somebox/rgb-spotlight/DESIGN.md

# RGB Spotlight — design notes

Status (2026-10-31): both boards routed and DRC clean, `pcbkit check` clean or explained (LAYOUT.md). One LED channel simulated (§2.7). Failure review in `docs/reviews/2026-10-30-v2.md`; its accepted changes are planned, not yet applied (§6, "Planned changes"). Next: apply them, settle LED polarity, then the order (PRODUCTION.md).

Chainable, WS2811-addressed RGB spotlight: three 3 W LEDs, each on its own PT4115 constant-current buck, run from a 12 V chain. Two boards in an aluminium cylinder:
- an **aluminium LED board** (50 mm, 1 layer) carrying only the LEDs;
- an **FR4 driver / interface board** (50 mm, 2 layers) 4–6 cm behind it, with the drivers, logic and connectors.

KiCad 10, generated by the project's scripts, with the shared tooling from pcb-kit (`~/src/pcb-kit`, `pcbkit ...`). The PCB itself is in [LAYOUT.md](LAYOUT.md), ordering in [PRODUCTION.md](PRODUCTION.md).

- **Schematics:** driver ERC 0/0 and 63 topology checks pass; LED board ERC shows 3 benign warnings (§4).
- **Boards:** LED board fully generated and routed; driver routed by script (LAYOUT.md). Both on the `disc50` outline preset.

| Path | What |
|---|---|
| `boards/driver/` | Driver / interface board (FR4). Schematic from `scripts/sch_driver.py`; board from `scripts/make_driver_pcb.sh` |
| `boards/led/` | LED board (aluminium). Schematic from `scripts/sch_led.py`; board from `scripts/make_led_pcb.sh` (placement and routing) |
| `lib/` | Project symbols (`PT4115`, `LED_HD2525`, 3-unit `LED_PORT`), footprints (`LED_XINGLIGHT_HD2525`, `WirePad_2.2x3.5mm`) and the 3D model, all written by `scripts/make_lib.py` |
| `scripts/` | The project's generators and checks (schematics, boards, routing, outline presets, netlist assertions). Shared parts come from pcb-kit: `pcbkit.schematic` (via `builder.py`), the silk placer, the blank board, DRC/ERC/checks, previews and fab |
| `sim/` | ngspice simulation of one LED channel (`sim/channel.py`, §2.7); tables and plots in `sim/results/` |
| `archive/v1-easyeda/` | v1 EasyEDA exports, the KiCad import of the v1 board, its as-built netlist, the v1 BOM doc and the bodge image |
| `docs/previews/<board>/` | Schematic PDF, front/back PNGs, 3D renders, printable PDF (`scripts/make_previews.sh` -> `pcbkit previews`); driver `placement-ratsnest.png` (`scripts/ratsnest.py`); `outline-presets.png` |
| `docs/BOM_driver.md`, `docs/BOM_led.md` | bomi BOMs. Each board folder has its own `.bomi/project.yaml` |
| `docs/datasheets/` | PDFs (git-ignored) plus bomi summaries |

```sh
python3 scripts/make_lib.py                         # project symbols + footprints
python3 scripts/sch_driver.py && python3 scripts/sch_led.py   # rebuild both schematics (Konnect); overwrites them
pcbkit erc boards/driver/driver.kicad_sch           # ERC summary (same for boards/led)
python3 scripts/netcheck.py                         # driver topology assertions (exit 1 on failure)
scripts/make_led_pcb.sh                             # LED board: placement, routing, islands, DRC (fully generated)
scripts/make_driver_pcb.sh --force --route          # driver board: placement + routing (about 6 min) + DRC; refuses hand-edited boards without --force
pcbkit drc boards/<b>/<b>.kicad_pcb --save && pcbkit check boards/<b>/<b>.kicad_pcb   # board checks (LAYOUT.md)
scripts/make_previews.sh [driver|led|all]           # docs/previews/<board>/
pcbkit release [--dry-run]                          # versioned order files in releases/<board>/v<version>/ (PRODUCTION.md, pcbkit.toml)
scripts/make_fab.sh <driver|led>                    # unversioned order files in build/fab/<board>/, for a look before releasing
python3 sim/channel.py                              # LED channel simulation (§2.7); add --plot under uv for the PNGs
<KiCad python> scripts/set_outline.py <driver|led|all> <disc50|disc55|disc60|tabs3>   # change the board edge in place (LAYOUT.md)
bomi --project boards/driver list --check           # stock check; same for boards/led
```

## Decisions

Numbered and dated; a reversal is a new entry naming the old one.

| # | Date | Decision | Why |
| --- | --- | --- | --- |
| D1 | 2026-10-05 | Restart in KiCad; v1 is not reworked (only a one-channel bodge for testing, §5) | v1 had the PT4115 stage wired as the wrong kind of buck and an unpowered 74HC04 (§1) |
| D2 | 2026-10-05 | PT4115 per its datasheet: 12 V → Rs → LED → L → SW, Schottky SW → 12 V | the datasheet topology for its low-side switch and high-side sense; v1 had it wrong (F1) |
| D3 | 2026-10-05 | One `+5V` net; netlist assertions for every v1 failure (`scripts/netcheck.py`) | F2; ERC can't tell intent |
| D4 | 2026-10-05 | J1 and J2 share one pinout (1 = 12V, 2 = DATA, 3 = GND) | v1's mirrored J2 needed reversed cables |
| D5 | 2026-10-05 | 68 µH inductor, 10 µF 50 V 1206 input caps, 0.22 Ω 1206 300 ppm sense resistors | PT4115 inductor table for 0.4–0.8 A; ≥ 4.7 µF after DC bias; tempco |
| D6 | 2026-10-05 | DIN: 100 Ω series + 10 k pull-down; DOUT: 33 Ω; WS2811 SET on a DNP 0 Ω strap | hot-plugged cables, defined idle, F3 open question |
| D7 | 2026-10-05 | Two boards: aluminium LED board + FR4 driver board 4–6 cm behind it | 2.7 W of LED heat needs an aluminium path to the housing (§2.6) |
| D8 | 2026-10-05 | LEDs spread on a 12 mm ring, each on its own copper island | separated colours are the intended effect; slug isolation unspecified |
| D9 | 2026-10-05 | JST XH 3-pin (3 A) in/out on the driver's back; JST PH 6 harness to the LEDs | chaining current; plastic connectors off the light side |
| D10 | 2026-10-05 | SMAJ15A TVS + 22 µF on the 12 V input | hot-plugged chain cables ring to ~2 × 12 V |
| D11 | 2026-10-06 | Parts and copper inside a 50 mm core; board edge from an outline preset | the housing (size, mounting) is not decided yet |
| D12 | 2026-10-11 | 12 V trunk as an arc from J1 over the top to the blue cell (no closed ring); PWR net class 0.8 mm, the 1.5 mm pass-through drawn explicitly | `pcbkit check`: no loops, class width = tap width |
| D13 | 2026-10-11 | Chain at most 6 lights per 12 V feed (2.5 A); 7 is at the XH connector's 3 A. Replaced by D14 | simulated 0.42 A per light at full white (§2.7) |
| D14 | 2026-10-31 | One 12 V feed runs at most 5 lights, up to 3 m apart on 22 AWG: 36 W supply for 4 lights plus controller, 60 W for 5 (§2.4). Replaces D13 | at the tolerance corners 5 lights draw 2.43–2.62 A, 6 about 2.9 A or more, on a 3 A connector with no derating for a warm housing. The board can't run from 5 V (review, "Power and data") |
| D15 | 2026-10-31 | 3 A fuse per feed at the supply end. Longer chains get another feed per group of 5, pin 1 open between groups | the supply can outrun the XH rating, and it limits a reversed cable (review R5, R7). No board change |
| D16 | 2026-10-31 | No extra repeater on the board | each light already has pcb-kit's repeater part on its input (U7) and the WS2811 reshapes on its output. Simulated clean over 8 m (review, "Power and data"), and the datasheet allows 4 m |
| D17 | 2026-10-31 | Planned: U6 74HC04 → 74HC14D (C5605, Basic) | WS2811 edges can be 120 µs; the 74HC04 needs under 139 ns/V or may oscillate (review R4). Same pinout |
| D18 | 2026-10-31 | Planned: C1 100 nF → 1 µF (C52923); R10 100 Ω → 1 kΩ (C11702). Replaces D6's 100 Ω | datasheet's Ci for VDD (R3); limits the clamp current from 12 V on the data pin and from cable ringing (R6) |
| D19 | 2026-10-31 | Planned: "+" on the LED board's silk at pad 2 of each LED, polarity in the order remark | the part's dot marks the anode, our silk and LCSC's dot mark pad 1, the cathode (R1) |
| D20 | 2026-10-31 | Nylon washers or screws on the driver; a sleeve or grommet through the LED board's wire hole | the housing floats and can isolate the board, so no keep-out re-route is needed (R8, R9) |

---

## 1. v1 post-mortem (EasyEDA, ordered Mar 2026)

Sources: the EasyEDA schematic and PCB exports (2026-10-05), the as-built netlist taken from the PCB pads (`archive/v1-easyeda/v1-netlist.txt`), a copper connectivity trace of the KiCad import (`v1-easyeda.kicad_pcb`), and the bench measurements in the Cursor review transcript.

**Measured on the board (transcript):** 12 V and 5 V present on the IC pins; 400 kHz data present on DIN and on DIN_5V (5–6 V p-p); WS2811 VDD = 5 V; WS2811 OUTR/G/B silent (DIM_x_RAW sits at 5 V); a 2 kΩ pull-up on DIM_G did nothing; the same ESP32 output drives a WS2812 panel fine.

### F1 — PT4115 power stage wired as the wrong kind of buck (all three channels) — would never light

v1 wired each channel like a conventional buck with a *high-side* switch:

```
v1:   12V ─ Rs ─ CSN            (Rs carries no LED current: only the 8 µA CSN pin current)
      SW ─┬─ L ─ LED(A→K) ─ GND
          └─ D (K on SW, A on GND)
```

The PT4115 is a **low-side** switch (SW is the drain of an internal NMOS to GND) with **high-side** current sense. The datasheet (§8, application figure 1) puts the LED and inductor between the sense resistor and SW:

```
v2:   12V ─ Rs ─┬─ CSN
                └─ LED(A→K) ─ L ─ SW      D: A on SW, K on 12V (VIN)
```

With the v1 wiring no LED current can flow:

- with the switch on, SW is at 0 V and so is everything on the LED's side;
- with it off, nothing sources current.

Rs sees 0 mV, so the comparator holds the switch on permanently. Forcing DIM high would not have lit anything either. The v1 BOM doc's connection tables (`archive/v1-easyeda/rgb-spotlight-bom-v1.md`) and the Cursor review ("PT4115 buck topology is correct … Schottky anode to GND, cathode to SW … LED cathode to GND") both describe this same wrong topology.

### F2 — 74HC04 VCC on its own net

The schematic used two power names, `+5V` and `5V`. U6 pin 14 and C2 sat on `+5V`, which connects only to C2 (copper trace confirms: U6.14 → C2.2 only). The inverter was unpowered or back-fed through its input clamps, so the DIM pins were undefined. This is probably one of the "miswirings" fixed by hand. v2 has one `+5V` net, and `netcheck.py` asserts every logic VCC is on it.

### F3 — WS2811 receives data but its outputs never change (open)

2026-10-31: the owner recalls later seeing PWM from the chip on a scope, but v1 had too many faults for that to settle anything, so F3 stays open. Treat the WS2811 as untested until v2 bring-up.

Copper was checked pad by pad on the import:

- J1.2 → U7.2 (A), and U7.4 (Y) → U1.6 (DIN). **U7's A and Y are not swapped.**
- U1.8 → 5 V and U1.4 → GND are both connected, and the U1 footprint pin order matches the datasheet.

So the board connects correctly. The candidates left, with the tests in §5:

1. **Latch (reset) time.** The Worldsemi V2.2 datasheet needs **≥ 280 µs low** before outputs update. Older WS2812 parts latch after 50 µs, and some drivers only leave about 50 µs between frames. If frames arrive back to back, the WS2811 shifts data but never latches. That matches the symptom: outputs stuck off while data is present.
2. **Data rate.** The V2.2 part is specified at 800 kbit/s only (T0H 220–380 ns, T1H 580 ns–1 µs). The 400 kHz "WS2811 mode" (T0H ≈ 500 ns, T1H ≈ 1.2 µs) is outside its spec. Test at 800 kHz, which is FastLED's plain `WS2811` (not `WS2811_400`).
3. **Pin 7.** V2.2 calls it NC, but older WS2811 datasheets and clones use it as SET (400/800 kHz select). v1 left it floating. v2 adds a do-not-fit 0 Ω strap (R9) to +5V.
4. **Placement or damage.** U1 may have been placed rotated (check the pin-1 dot against the silkscreen) or damaged during the earlier miswiring.

### Checked and correct in v1

- 78L05G-AB3-R pinout on the PCB: 1 OUT, 2 GND, 3 IN, per the UTC ordering table "O G I". The *v1 BOM doc table* listing pins as GND/VIN/VOUT was wrong, but the schematic and PCB were right.
- WS2811, 74HC04 and 74AHCT1G125 pin maps.
- LED pads (EasyEDA symbol: pad 1 = K, pad 2 = A). Physical orientation is still to be verified (§6).

### Convention, not a fault: connector pin order

v1 used J1 = 12V/DIN/GND and J2 = GND/DOUT/12V, so the chain depends on a reversed (pin 1 ↔ pin 3) cable. A pin-1-to-pin-1 cable would put 12 V on the next board's GND. v2 gives both connectors the same order (1 = 12V, 2 = data, 3 = GND) for pin-1-to-pin-1 cables. **Check which kind of JST PH cable you have.** If yours are reversed, swap J2's pins 1 and 3 in `sch_main.py`.

---

## 2. v2 circuit

### 2.1 LED channels (×3, PT4115)
- Topology per datasheet: 12 V → Rs → (CSN, LED anode); LED cathode → L → SW; Schottky anode on SW, cathode on 12 V; 10 µF across VIN–GND at the pin.
- **I_LED = 0.1 V / Rs = 0.1 / 0.22 = 455 mA.** Datasheet limits: Rs ≥ 0.082 Ω, LED max 1 A / 3 W. Rs dissipation is 45 mW (1206, 250 mW).
- **Inductor 68 µH** (FNR6045S680MT, Isat 1.1 A, DCR 0.38 Ω). The datasheet table gives 47–68 µH for 0.4–0.8 A, and Isat ≥ 1.3–1.5 × I_out. v1 used 100 µH, the value for I ≤ 0.4 A.
- **Switching frequency** (hysteresis ±15 % → ΔI ≈ 136 mA; R_SW 0.6 Ω at 12 V):
  - red, VF ≈ 2.2 V: t_on ≈ 1.0 µs, t_off ≈ 3.2 µs, so ≈ 240 kHz;
  - green/blue, VF ≈ 3.2 V: t_on ≈ 1.15 µs, t_off ≈ 2.3 µs, so ≈ 290 kHz.

  Both are under the 1 MHz limit.
- **Input cap** 10 µF 50 V X5R 1206. The datasheet asks for at least 4.7 µF; v1's 0805 25 V part keeps only about 3–4 µF at 12 V bias.
- **DIM:** 0 V = off, > 2.5 V = full, internal 200 kΩ pull-up to 5 V, abs max 6 V. It is driven by 74HC04 outputs at 5 V.
  - WS2811 PWM runs at about 4 kHz. The PT4115 holds its 0.02 % minimum duty at 100 Hz but needs 4 % at 20 kHz. Expect roughly the bottom 1 % (2–3 of 255 levels) to be dark or non-linear.

### 2.2 Data path
- **J1.2 → R10 100 Ω → (R7 10k to GND) → 74AHCT1G125 → WS2811 DIN.** R10 limits current into the buffer input when a hot-plugged cable rings.
  - AHCT input VIH = 2.0 V, so 3.3 V or 5 V controllers both work; WS2811 VIH is 0.55·VDD = 2.75 V.
  - R7 holds the line low when unplugged, which also keeps the WS2811 in reset.
  - OE is tied straight to GND. v1's R7 pull-down on OE did the same job; that resistor now goes to DIN.
- **WS2811 DO → R8 33 Ω → J2.2:** source termination for the cable. Each WS2811 regenerates the signal at 5 V.
- **R9 (0 Ω, not fitted):** pin 7 (SET) to +5V. Fit it only if bring-up shows the part needs it (§1 F3).

### 2.3 Inversion (unchanged idea, now powered)
WS2811 outputs are 20 V-tolerant constant-current sinks (≈ 16 mA) and sink when a channel is on.
- R4–R6 (4.7 kΩ to 5 V) limit that to 1.06 mA, so the outputs pull fully low.
- The 74HC04 inverts, so DIM is high when the channel is on: 0xFF → full on, 0x00 → off, with standard NeoPixel software.
- Gates 4–6: inputs to GND, outputs open.

### 2.4 Logic supply and 12 V input
78L05 (SOT-89, O-G-I) from 12 V, with 10 µF in and 100 nF out. Load is about 5 mA: WS2811 0.3 mA, 3 × 1.06 mA pull-ups, R7 up to 0.5 mA, gate quiescent. That dissipates ≈ 35 mW. Each logic IC has its own 100 nF.

**12 V input:** an SMAJ15A TVS (breakdown ≥ 16.7 V, clamps 24.4 V) and a 22 µF 1206 at J1. Hot-plugging a cable onto ceramic-only inputs can ring to about 2 × 12 V; the PT4115 is rated to 35 V and the caps to 25/50 V.
- J1 → J2 carry +12V and GND straight through; JST XH is rated 3 A.
**Power for one feed (D14).** A feed is one 12 V supply output, fused, running up to 5 lights at full white. Worst case means the high-current corner with the highest LED VF bins (5.51 W per light); typical is the simulated 5.0 W (§2.7). The worst case stays at 5.51 W as the voltage falls, so the current rises. Numbers are in `sim/results/worst_case.txt`, with 22 AWG and XH contacts assumed at 20 mΩ each.

| Lights | Spacing | Typical | Worst case | Share of XH 3 A | Last light |
| --- | --- | --- | --- | --- | --- |
| 4 | 1 m | 1.71 A, 21 W | 1.89 A, 23 W | 63 % | 11.4 V |
| 4 | 3 m | 1.77 A, 21 W | 1.96 A, 24 W | 65 % | 10.7 V |
| 5 | 1 m | 2.19 A, 26 W | 2.43 A, 29 W | 81 % | 10.9 V |
| 5 | 3 m | 2.34 A, 28 W | 2.62 A, 31 W | 87 % | 9.6 V |

- **Feed voltage:** regulated 12 V, 11.4–13 V at the first light. Stay under 15 V, the TVS's standoff. The PT4115 needs 6 V and the 78L05 7 V, so voltage isn't the limit; connector current is.
- **Supply size:** 36 W (12 V 3 A) for 4 lights plus a controller, 60 W (12 V 5 A) for 5 lights plus a controller. Allow about 3 W for an ESP32 controller on a 12 V to 5 V stepdown. A 36 W supply would run at 96 % for 5 lights and a controller in the worst case.
- **Fuse:** 3 A at the supply end of each feed (D15). The supply can deliver more than the connectors are rated for.
- **Spacing:** up to 3 m between lights on 22 AWG. The WS2811 datasheet gives 4 m between two chips as its limit.
- **Longer chains:** start a new group at the sixth light, with its own feed and fuse. Leave pin 1 (12 V) open on the cable between groups and keep data and GND connected, so that two feeds never run in parallel through a connector. No board change.
- **Dark:** about 10 mA per light at 12 V (estimate, from the §2.4 logic load plus regulator quiescent current).
- **Switch-on:** 62 µF nominal per light, about half at 12 V bias, so up to 310 µF on a feed. It's small for a 3 A fuse, but the first power is still through a current-limited supply.
- **At PWM mid-levels:** a channel's average current falls with level, but its peak doesn't, so the feed still sees steps of about 0.45 A per light at 4 kHz (§2.7 Q3).

### 2.5 Mechanical: two boards in an aluminium cylinder (2026-10-05)
- **LED board** (aluminium, 1 layer, 50 mm):
  - LEDs on a ring at r = 12 mm (R 90°, G 210°, B 330°). They are spread apart on purpose: the colours stay separate.
  - Each LED sits on its own large copper island (`HEAT_R/G/B`), never joined. That makes the slug-isolation question moot, and the dielectric isolates the islands from the aluminium.
  - A 6.4 mm centre hole passes the wires. The six wire pads around it are soldered on the front; the wires go straight through the hole.
  - Three M3 holes at r = 19 mm (30° / 150° / 270°) bolt it to the housing's heat plate with thermal paste or a pad.
- **Harness:** six 24 AWG wires, twisted per colour, soldered to the LED board and crimped into a JST PH 6 housing. Pin order: R+ R− G+ G− B+ B−.
  - The LED pins are not the switching node (that is SW, between L and the PT4115 on the driver board). The wires carry DC with about ±15 % ripple at 240–290 kHz, so 4–6 cm is no problem.
- **Driver board** (FR4, 2 layers, 50 mm, about 1 W):
  - Front faces the LED board: all SMD parts, plus J3 (PH 6 vertical) at the centre.
  - Back faces the housing's back: J1 IN and J2 OUT (XH 3 vertical, through-hole). They are reachable through cut-outs in the back cap, or by short pigtails to panel connectors.
  - Three M3 holes at r = 11 mm for standoffs.
- **Power per light at full white** (simulated, §2.7):
  - LEDs 1.07 + 1.48 + 1.52 W = 4.07 W electrical;
  - driver losses 0.92 W (diode 0.44, inductor 0.21, Rs 0.14, switch 0.12);
  - total **5.0 W in, 0.42 A at 12 V** (the hand estimate of 4.5 W / 0.38 A was low).

### 2.6 Thermal estimate (2026-10-05)

Full white at 455 mA. Assumptions:
- LED wall-plug efficiency ≈ 30 % red, 20 % green, 35 % blue;
- LED junction-to-slug ≈ 10 °C/W (the datasheet gives only Tj max = 125 °C);
- still air h ≈ 10–12 W/m²K, counting both faces.

| | Value |
|---|---|
| Heat in LEDs | R 0.67 W, G 1.09 W, B 0.92 W, so **2.7 W**, all within about 7 mm of the centre |
| Heat in drivers | ≈ 0.3 W per channel (diode, switch, DCR, Rs), so **0.9 W** |
| One 50 mm FR4 disc, free-standing | 21–25 °C/W to air, even with ideal spreading, so **+77–92 °C** (board ≈ 100–115 °C, LEDs at or past Tj max). **Needs a heatsink** |
| FR4 + via array (0.3 mm via ≈ 190 °C/W each, 10 vias ≈ 19 °C/W) onto a heatsink | Tj(green) ≈ T_heatsink + 33 °C: 78 °C at a 45 °C heatsink |
| Aluminium MCPCB (≈ 1.5 W/mK, 0.1 mm dielectric, ≈ 3 °C/W) | Tj(green) ≈ T_heatsink + 14 °C: 59 °C at a 45 °C heatsink |
| Heatsink for a 45 °C base at 25 °C ambient | ≈ 5.5 °C/W for 3.6 W |

**Conclusion:** a heatsink is needed either way. Aluminium keeps the LEDs about 20 °C cooler than FR4 with vias. Without a heatsink, run about 200–300 mA (Rs = 0.47 / 0.33 Ω).

**Decision (2026-10-05):** LEDs go on an aluminium board bolted to the housing's heat plate, and the driver goes on its own FR4 board (§2.5).
- The 2.7 W of LED heat goes into the aluminium cylinder, which has passive vents.
- The driver's 0.9 W is spread over its own disc.
- Spreading the LEDs to r = 12 mm also spreads their heat.

### 2.7 Simulation of one LED channel (2026-10-11)

`sim/channel.py` runs ngspice through `pcbkit.spice`. The table is in `sim/results/channel.txt` and the plots in `sim/results/channel_full.png` and `channel_pwm.png`.
- **Model:** the PT4115 has no SPICE model, so it is behavioural, built from its datasheet. It's a switch that turns on below 85 mV across Rs and off above 115 mV, gated by DIM, with 0.6 Ω on-resistance and an assumed 150 ns comparator delay.
- **Around it:** the board's real L (68 µH, 0.33 Ω), Rs, B5819W (fitted to 0.6 V at 1 A), Cin about 6 µF at 12 V, and 12 V through 1 m of cable (0.1 Ω, 1 µH) with C9.
- **LEDs:** knee voltage + 0.55 Ω, at the datasheet VF.
- **Left out:** temperature, inductor saturation, SW-node parasitics, and the PT4115's start-up delay after DIM rises.

**Q1: full brightness.** About 460 mA in every colour, against 455 mA set by Rs.

| Colour | I_LED | Ripple | f_sw | P_LED | Losses (D / L / Rs / switch) | P_in | Efficiency |
| --- | --- | --- | --- | --- | --- | --- | --- |
| red | 461 mA | 163 mA pp | 206 kHz | 1.07 W | 0.16 / 0.07 / 0.05 / 0.03 W | 1.38 W | 78 % |
| green | 459 mA | 163 mA pp | 240 kHz | 1.48 W | 0.14 / 0.07 / 0.05 / 0.04 W | 1.78 W | 83 % |
| blue | 458 mA | 163 mA pp | 243 kHz | 1.52 W | 0.14 / 0.07 / 0.05 / 0.04 W | 1.83 W | 83 % |

- **Ripple** is ±18 %: the ±15 % hysteresis plus overshoot from the comparator delay. The LED wires carry it at 200–250 kHz (D9, twisted pairs).
- **The Schottky is the hottest part.** At 0.14–0.16 W and 160 °C/W (the datasheet figure, which assumes a large pad) it rises about 25 °C. With the small SOD-123 pads, expect 35–40 °C, so about 80 °C in a 40 °C housing. That is within its rating.
  - A lower-VF Schottky in SMA (SS14 class) would save about 0.05 W per channel and run cooler. It's worth it if the housing runs warm.
- **The PT4115** dissipates only about 0.04 W in its switch: a 2 °C rise.
- **Whole light at full white:** 5.0 W, 0.42 A at 12 V, 4.07 W of it into the LEDs (D14).

**Q2: PWM linearity.** The WS2811 drives DIM at about 4 kHz (250 µs period). Green, average LED current against duty × 459 mA:

| Duty (level/255) | 100 % | 50 % (128) | 20 % (51) | 10 % (26) | 5 % (13) | 2 % (5) | 1.6 % (4) | 1 % (2.6) | 0.8 % (2) | 0.4 % (1) |
| --- | --- | --- | --- | --- | --- | --- | --- | --- | --- | --- |
| Brightness / ideal | 1.00 | 1.02 | 1.05 | 1.10 | 1.20 | 1.66 | 1.49 | 0.90 | 0.66 | 0.21 |

- **Two effects, both from the inductor:**
  - When DIM rises, the current ramps up in about 3.5 µs at (12 − VF)/L.
  - When DIM falls, the current keeps flowing through the LED and the Schottky for about 9 µs while the inductor empties.
- **Low duty runs bright:** each pulse gains a net ≈ 1.3 µC, which is +10 % at 10 % duty and +66 % at 2 %.
- **Below about 1 % it runs dark:** the current never reaches its set value.
- **The real IC is dimmer still at the bottom.** The datasheet's minimum duty implies a ~2 µs start-up delay after DIM rises, which the model doesn't include. Levels 1–2 will likely be dark, and 3–8 dim and uneven.
- **The response is monotonic** in the model. For smooth fades, use the controller's gamma correction and keep the bottom few levels out of animations. A bench measurement of brightness against level would give a correction table.

**Q3: the 12 V input.**
- At full brightness a channel draws 149 mA, with 20 mA pp of switching ripple at the board.
- With PWM it draws pulses of up to about 290 mA at 4 kHz, and the board's 12 V dips 77 mV per channel (1 m cable).
- The WS2811 starts all three channels' PWM periods together. Expect steps of about 0.45 A per light and a dip of about 0.2 V at 4 kHz. That's harmless to the PT4115s and the 78L05.
- **Bench check:** ceramic caps (C6–C9) can sing audibly at 4 kHz.
- **Long chains:** the steps add up along the cable. Inject power at the start of each group of 5 (D14).

## 3. Parts (bomi: `docs/BOM_driver.md` 19 lines ≈ $2.18; `docs/BOM_led.md` 3 lines ≈ $0.77, qty 1)

| Board | Ref | Part | LCSC | Note / change from v1 |
|---|---|---|---|---|
| LED | LED1–3 | XL-HD2525 SURC / UGC / UBC | C49237857 / 859 / 860 | **green stock low** (bomi check: 325) |
| LED | TP1–TP6 | wire pads 2.2 × 3.5 mm | — | not in the BOM; hand-soldered wires |
| driver | U1 | WS2811 SOP-8 | C114581 | |
| driver | U2–U4 | PT4115 SOT-89-5 | C347356 | stock KiCad `SOT-89-5` footprint (pad 2 = tab = GND) |
| driver | U5 | 78L05G-AB3-R | C71136 | Basic |
| driver | U6 | 74HC04D | C5590 | |
| driver | U7 | SN74AHCT1G125DCKR | C350557 | |
| driver | L1–L3 | FNR6045S680MT 68 µH | C168091 | was 100 µH C168095 |
| driver | D1–D3 | B5819W | C64885 | now SW → 12 V |
| driver | D4 | SMAJ15A TVS | C19077535 | new (Preferred) |
| driver | R1–R3 | 0.22 Ω 1 % 1206, 300 ppm | C2907349 | was 0805, 800 ppm (C247160) |
| driver | R4–R6 | 4.7 kΩ 0402 | C25900 | |
| driver | R7 | 10 kΩ 0402 | C25744 | now the DIN pull-down |
| driver | R8 | 33 Ω 0402 | C25105 | new: DOUT series |
| driver | R9 | 0 Ω 0402 | — | new, **DNP**: SET strap |
| driver | R10 | 100 Ω 0402 | C25076 | new: DIN series |
| driver | C1–C4 | 100 nF 0402 | C1525 | |
| driver | C5 | 10 µF 25 V 0805 | C15850 | |
| driver | C6–C8 | 10 µF 50 V 1206 | C13585 | was 0805 25 V |
| driver | C9 | 22 µF 25 V 1206 | C12891 | new: 12 V input bulk |
| driver | J1, J2 | JST B3B-XH-A, vertical THT, back side | C144394 | was PH SMD right-angle; 3 A for chaining |
| driver | J3 | JST B6B-PH-K-S, vertical THT | C131342 | new: LED harness |

## 4. Verification

- **Driver ERC:** 0 errors, 0 warnings (`scripts/erc.py`).
- **LED ERC:** 3 warnings, `isolated_pin_label` on HEAT_R/G/B. They are benign: each island is meant to connect to one pad only.
- **`scripts/netcheck.py`** (63 assertions, driver) checks the v1 failure points directly:
  - each channel's 12 V → Rs → CSN / J3 x+ … J3 x− → L → SW, and D from SW to 12 V;
  - the CSN, LED-cathode and SW nodes hold nothing else;
  - DIM comes from a 74HC04 output;
  - every logic VCC is on +5V; the 78L05 pinout; the TVS orientation; R10/R7; the connector pinout; no single-node nets.
- **DRC with schematic parity:** both boards clean (the driver is unrouted).

## 5. Bench tests on the v1 boards (before ordering v2)

### Data path (F3)
Hold the scope or DMM ground on J1.3.

1. **Is the WS2811 decoding?** Configure ≥ 2 pixels in firmware and scope **J2.2 (DOUT)**. A decoding WS2811 forwards everything after the first 24 bits.
   - **Bits on DOUT:** the chip receives and decodes. Go to step 2.
   - **DOUT silent:** go to step 3.
2. **Latch:** add a gap after each frame (e.g. `FastLED.show(); delayMicroseconds(500);`) or send one frame and stop, at **800 kHz** (FastLED `WS2811`, not `WS2811_400`). Expected: DIM_x_RAW drops to ≈ 0 V for full white.
3. **If DOUT is silent:**
   - check U1's pin-1 dot against the silkscreen;
   - try pin 7 tied to 5 V, then to GND;
   - otherwise swap the WS2811.

### Power stage (F1): bodge one channel
Red channel, marked up in `archive/v1-easyeda/bodge-red-channel.png`. It drives an **external** LED. The on-board LED can't be reused: its cathode pad sits under the body and is wired to GND.

1. **Remove LED1.** Photograph its orientation first. Once it's off:
   - diode-test it to settle §6 item 1 (in v1 the pad nearer the board centre was the GND/cathode pad);
   - wick its pads flat.
2. **Cut the DIM_R trace** where it leaves U2 pin 3 (top-left pin of U2 in the image).
   - With DIM disconnected, the PT4115's internal pull-up turns the channel on.
   - This takes the 74HC04 and WS2811 out of the test.
3. **Add a Schottky** (1N5819, SS14, or any ≥ 1 A / ≥ 20 V part):
   - anode on D1's left pad (the SW node, also U2 pin 1);
   - banded cathode on C6's upper pad (+12 V).
   - Keep the leads short: this is the switching loop.
   - Leave D1 in place: in the new circuit it is always reverse-biased.
4. **Wire R1's left pad** (the end that beeps to U2 pin 4, **not** 12 V) to the external LED's **+**.
5. **Wire LED1's former outer pad** (the one toward L1, joined to L1 by the trapezoid copper) to the external LED's **−**.
   - Scraping the mask on the trapezoid gives a bigger target.
   - This wire must **not** beep to GND: shorting it to GND would put the LED straight across 12 V through R1.

**Resulting loop:** 12 V → R1 → LED+ … LED− → L1 → SW (U2) → GND, freewheeling through the new Schottky back to 12 V.

**External LED:** a 3 W "star" LED on a heatsink, since the channel runs 455 mA with R1 = 0.22 Ω. For a gentler first try, swap R1 (0805) for 0.47 Ω (≈ 210 mA).

**Power-up:** bench supply at 12 V with the current limit at about 0.25 A. Expect:
- about 0.1–0.15 A drawn;
- about **100 mV across R1** (= 455 mA);
- a 0 ↔ 12.4 V square wave at roughly 150–250 kHz on D1's left pad (with v1's 100 µH).

If the supply hits its current limit, power off and check the new diode's direction and wire 5.

**Afterwards:** bridge the DIM cut with solder and go back to the data-path tests above. Once the WS2811 decodes, red = 255 should light this LED.

## 6. Open items (before ordering v2)

1. **LED orientation.** The datasheet top view puts the dot at pad ② (anode). The LCSC/EasyEDA footprint (which JLC uses) puts its dot at pad 1 (cathode).
   - Our footprint has pad 1 = cathode at −x, with silk closing that side.
   - Check on a v1 board: diode-test LED1, red probe on the L1-side pad (v1 pad 2), black on GND (pad 1). It should glow faintly.
   - Then confirm polarity in JLC's DFM preview.
2. **WS2811 behaviour (F3)** from §5. If it stays unexplained, consider another 12 V WS2811-protocol controller.
3. **Chain cables:** J1/J2 now share one pinout, so use pin-1-to-pin-1 XH cables or pigtails.
4. **Green LED stock:** 325 at the last check. Order early, or find an alternate.
5. **Housing fit:** pick the outline preset once the housing is known (§7.3): `disc50` (current) / `disc55` / `disc60` / `tabs3`, or add one to `scripts/mech.py`.
   - Check the back-cap cut-outs over J1/J2 at r = 19.5 mm, 30° / 150°.
6. **Aluminium board order:** 1 layer, 1.6 mm, 1–2 W/mK. JLC assembles the LEDs.

### Planned changes (2026-10-31, not applied)

From the failure review; D17–D19 and D20's assembly steps.

| Change | Files | Layout |
| --- | --- | --- |
| U6 → `74xx:74HC14`, value 74HC14, C5605, MPN 74HC14D,653 | `scripts/sch_driver.py`, `scripts/netcheck.py` messages, value on the board, bomi, DESIGN §3 | none |
| C1 → 1 µF, C52923 | as above | none, same 0402 |
| R10 → 1 kΩ, C11702 | as above, DESIGN §2.2 | none, same 0402 |
| "+" at pad 2 of LED1–3 | `scripts/gen_led_pcb.py`, the LED board as an incremental edit | silk only |
| Harness sleeve, nylon hardware, order remark | PRODUCTION.md | none |

Then `pcbkit erc`, `scripts/netcheck.py`, `pcbkit cleanup`, `pcbkit drc --save`, `pcbkit check`, the previews and BOMs, and `pcbkit release --dry-run`. Boards stay at v2.0 until released.

**Before ordering:** diode-test a v1 LED and check all three in JLC's preview (§6 item 1). Order the smallest assembled run, since neither the WS2811 (F3) nor the PT4115 stage has been proven on hardware. R9 stays as a footprint in case pin 7 turns out to matter.

## 7. PCBs

Moved to [LAYOUT.md](LAYOUT.md) (2026-10-11): floor plans, rules, scripted copper, routing, outline presets and the checks.
