somebox/rgb-spotlight/HANDOVER.md

# RGB Spotlight: handover

Status (2026-11-03): v2.0 is designed, routed and DRC clean on both boards, and has had a pre-order failure review. The
review's accepted changes are **planned, not applied**. Nothing has been ordered. This page is the way in; the detail
stays in the documents it links to.

## How we got here

1. **v1 (EasyEDA, one FR4 board, ordered Mar 2026) never lit.** The post-mortem is in [DESIGN.md §1](DESIGN.md):
   - F1: the PT4115 stages were wired as a high-side buck, so no LED current could flow;
   - F2: the 74HC04's VCC sat on an orphan net;
   - F3: the WS2811 received data but its outputs never moved. That one was never explained (see "What we know and
     don't" below).
2. **v2 restart in KiCad (2026-10-05 to 10-12):** two boards in an aluminium cylinder (D7):
   - an aluminium LED board carrying only the three 3 W LEDs;
   - an FR4 driver board with the WS2811, three PT4115 bucks, the logic and the connectors.

   Both boards are generated by the scripts in `scripts/` on top of pcb-kit (`~/src/pcb-kit`). One LED channel was
   simulated in ngspice (`sim/channel.py`, DESIGN §2.7). Commits `05d2b1d` and `3daf257`.
3. **pcb-kit release flow (2026-10-30):**
   - `pcbkit.toml` sets up versioned releases;
   - silkscreen version labels read v2.0;
   - PRODUCTION.md has the release steps and the order checklist.

   Commit `1610d73`.
4. **Failure review (2026-10-30 to 11-03):** [docs/reviews/2026-10-30-v2.md](docs/reviews/2026-10-30-v2.md). Every
   block was checked against its datasheet, with worst-case numbers (`sim/worst_case.py`) and a data-cable
   simulation (`sim/data_cable.py`). The owner's answers are recorded there and turned into decisions D14–D20 in
   DESIGN.md.

## Decisions made in the review (DESIGN.md, D14–D20)

| # | Decision | State |
| --- | --- | --- |
| D14 | One 12 V feed runs at most 5 lights, up to 3 m apart on 22 AWG. Power table in DESIGN §2.4. Replaces D13's 6 | in the docs |
| D15 | 3 A fuse per feed at the supply end; longer chains get a feed per group of 5, with pin 1 open between groups | in the docs |
| D16 | No extra repeater: U7 (SN74AHCT1G125) is pcb-kit's repeater part already, and each WS2811 regenerates the data | in the docs |
| D17 | U6 74HC04 → 74HC14D (C5605), for the WS2811's slow output edges | **planned** |
| D18 | C1 100 nF → 1 µF (C52923); R10 100 Ω → 1 kΩ (C11702) | **planned** |
| D19 | "+" silk at pad 2 of each LED; polarity stated in the order remark | **planned** |
| D20 | Nylon hardware on the driver; a sleeve through the LED board's wire hole (the housing floats) | in PRODUCTION.md |

**Power, in short:**
- Feed: regulated 12 V, never over 15 V (the TVS's standoff).
- 4 lights take 21 W typical and 24 W worst case: use a 36 W supply, controller included.
- 5 lights take 26–28 W typical and 29–31 W worst case: use a 60 W supply.
- The board can't run from 5 V. The PT4115 needs 6 V, and the 78L05 needs 7 V.

## What we know and don't

- **Checked:**
  - Pinouts, values and voltages for every IC against its datasheet (the review's "Verified OK" list).
  - ERC 0, DRC 0/0 with parity, and `netcheck.py` 0 failures on 2026-10-29. Re-run them after the planned edits.
- **Not proven on hardware:**
  - **The WS2811 (F3, review R2).** The owner recalls PWM from the chip on v1, but v1 had too many faults for that to
    count.
  - **The PT4115 stage.** v1's was miswired, so it has only been simulated.

  The first v2 boards are the test, so order the smallest assembled run.
- **Firmware:** FastLED `WS2811` (800 kHz) meets the WS2811's timing; `WS2811_400` doesn't. ESPHome's built-in `WS2811`
  chipset timing is outside the datasheet, so use the custom timing in the review's firmware duties. WLED wasn't
  checked.

## Work remaining, in order

1. **Apply the planned changes.** The edit list is in DESIGN §6, "Planned changes":
   - `scripts/sch_driver.py` and the netcheck messages;
   - incremental edits to the boards, keeping UUIDs (never regenerate a routed board);
   - bomi and the BOM docs.

   Then run `pcbkit erc`, `scripts/netcheck.py`, `pcbkit cleanup`, `pcbkit drc --save`, `pcbkit check`, and
   regenerate the previews.
2. **LED polarity (R1).**
   - Diode-test one v1 LED. This tests the part, so v1's faults don't matter.
   - Then check all three LEDs in JLC's placement preview: the part's dot is the anode (pad 2).
3. **Release and order:**
   - `pcbkit release --dry-run`, then `pcbkit release`;
   - an order under `production/orders/`;
   - PRODUCTION.md's checklist, including the never-checked SOT-89 and SOT-353 rotations (R11);
   - order soon after: blue LED stock was 704 (R14).
4. **Bring-up:** the review's bench list. Use a current-limited first power, then one colour at a time. Record the
   results in the review, dated:
   - D1's temperature (R10);
   - DIM edges (R4);
   - the 5 V rail current (R3);
   - five lights on one feed.

## Open questions

- Housing: which outline preset (DESIGN §6 item 5), and do the back-cap cut-outs line up with J1/J2?
- Home Assistant path: ESPHome (timing given) or WLED (not checked)?
- Test access: untent one via per key net (review, "Test points")? Free, but not yet decided.

## Where things are

| What | Where |
| --- | --- |
| Design notes, decisions, planned changes | [DESIGN.md](DESIGN.md) |
| Layout and checks | [LAYOUT.md](LAYOUT.md) |
| Ordering, harness, bring-up | [PRODUCTION.md](PRODUCTION.md) |
| Failure review, bench list, firmware duties | [docs/reviews/2026-10-30-v2.md](docs/reviews/2026-10-30-v2.md) |
| Simulations and their tables | `sim/` and `sim/results/` |
