somebox/rgb-spotlight/docs/reviews/2026-10-30-v2.md

# RGB Spotlight v2.0 (driver + LED board): failure review

Status (2026-10-30): reviewed at `1610d73`. Covers both boards: 12 V input and chaining, 5 V logic, data path,
WS2811 and inverter, the three PT4115 channels, the LED board and harness, mounting, fab and assembly, firmware
duties. Not covered: EMI, the housing's thermal behaviour (nothing measured), KiCadRoutingTools' checkers (§Not covered).
Nothing in the design has been changed; the numbers are in `sim/results/worst_case.txt` (`sim/worst_case.py`).

Updated 2026-10-31 with the owner's answers (§Answers). R2 stays open, the §Power and data section is new, and R5's numbers are corrected. Accepted changes are planned in DESIGN §6 and not yet applied.

## Verdict

**Not ready to order yet.** The board and BOM changes are agreed and planned (DESIGN D17–D19) but not applied. Before ordering:
1. Apply them and re-run the checks.
2. Settle LED polarity at JLC (R1).

Neither the WS2811 (R2) nor the PT4115 stage has been proven on hardware, and v1 can't prove them. Order the smallest assembled run and treat it as the first test.

## Findings

| # | Finding | Effect | Likelihood | Evidence | How it shows up, how to tell | Action |
|---|---|---|---|---|---|---|
| R1 | **LED polarity at assembly.** The HD2525's own dot marks the **anode** (pad ②). Our silk bracket and LCSC's footprint dot mark **pad 1 = cathode**. A placer or operator who lines up dot with mark fits the LED backwards. A reversed LED sits under 12 V reverse bias (CSN at 12 V; its cathode node pulled to 0 V through L and the PT4115's on-switch). The LED is rated VR 5 V. | dead (that colour); LED may be destroyed | possible | XL-HD2525 datasheet p.7 outline and "Polarity" (② +, ① −); DESIGN §6.1; `PLACEMENT-led.md` (no checked rule for the LEDs) | that colour stays dark while the others work; ~12 V across the LED wires at J3 with no current (100 mV across Rs means current flows; 0 mV means none) | **before ordering:** diode-test a v1 LED (DESIGN §6.1), which is a test of the part, not of v1's wiring; **accepted (D19):** add a "+" by pad 2 of each LED on the silk (silk edit only); put "LED cathode = pad 1, the side away from the package dot" in the order remark; check JLC's preview |
| R2 | **WS2811 not proven (v1 F3).** v2 uses the same part (C114581, V2.2) and the same DIN / VDD / output circuit as v1. v1 first showed data arriving and the outputs not moving. The owner later recalls seeing PWM from the chip on a scope, but v1 had too many faults for either result to count (2026-10-31). Driving it inside V2.2's timing is the known remedy, which is unproven here. | dead (no light responds) | possible | WS2811 V2.2 §switching characteristics; DESIGN §1 F3, §5; owner's recollection | DOUT silent, or the outputs never move at v2 bring-up step 4 | smallest assembled run; firmware inside the datasheet (below); R9 stays as a footprint. If v2 doesn't respond, try pin 7 and another WS2811 source before buying more |
| R3 | **WS2811 VDD straight on the 5 V regulator,** with 100 nF. The datasheet's reference circuit at 5 V uses Rd = 150 Ω in series and Ci = 1 µF. The chip has an internal zener that the datasheet expects to be fed through a resistor, and it doesn't state the zener voltage. VDD is rated 3.5–5.7 V; the 78L05 gives 4.8–5.2 V. If the zener sits below the regulator's output, it shunts the rail with no current limit. | function lost (U1 hot or damaged; data path dead) | unlikely (inferred: zener voltage unknown; v1 makes PWM with this circuit) | WS2811 V2.2 features ("内置稳压管… 只需串电阻到VDD"), §typical application 1 (Rd 150 R, Ci 1 µF), §max ratings | v1: measure the 5 V rail current with no data. Expect ≈ 5 mA (§2.4); tens of mA means the zener conducts | **accepted (D18):** C1 100 nF → 1 µF 0402 (C52923, Basic). **If the 5 V rail draws tens of mA at bring-up:** add Rd 150 Ω between +5V and U1.8 (one 0402 and a short re-route at U1) |
| R4 | **74HC04 on slow edges.** The WS2811's outputs are specified with up to 120 µs fall time (CL 300 pF). The 74HC04 needs input edges faster than 139 ns/V at 4.5 V, or it may oscillate while the input crosses its threshold. That chatter reaches DIM, so the PT4115 restarts several times per PWM edge. | degraded (flicker, noise, uneven low levels) | possible | WS2811 V2.2 tTHZ 120 µs max; Nexperia 74HC04 Δt/ΔV 139 ns/V at 4.5 V | scope DIM_x at a PWM edge: bursts of pulses instead of one clean edge | **accepted (D17):** U6 → **74HC14D,653 (C5605)**. It's a Basic part with the same pinout and function and Schmitt-trigger inputs, so the netlist, footprint and routing stay as they are |
| R5 | **Chain current at 6 lights is at the JST XH limit.** D13 assumes 0.42 A per light, which is the simulation at nominal values. At the tolerance corners a light draws up to 5.51 W: current-sense spread ±5 %, Rs 1 %, the highest LED VF bins. Six lights then pass about **2.9 A** or more through the first J1/J2, against XH's 3 A, which is rated with no derating for a warm housing. | degraded (warm contacts, oxidation over months) | possible | `sim/results/worst_case.txt`; DESIGN D9, D13 | contact temperature at the first light's J2 under full white; voltage drop across the mated pair | **Accepted:** 5 lights per feed (2.43–2.62 A worst, §Power and data), with a 3 A fuse per feed at the supply end (D14, D15) |
| R6 | **12 V reaching the data pin** (a mis-crimped cable with pins 1/2 swapped, or the plug mated at an angle). J1.2 → 100 Ω → U7's input, which is rated −0.5 to 7 V and has no clamp to VCC. Through 100 Ω its ESD structure takes up to ~50 mA. The WS2811's own DIN/DO pins survive a brief 24 V (datasheet), but U7 doesn't. | function lost (this light and everything after it get no data) | unlikely | TI SN74AHCT1G125 abs max VI 7 V; IIK only for VI < 0; inputs "overvoltage tolerant … up to 5.5 V" | data stops at this light; U7's output stuck; U7 input impedance low against a good board | **accepted (D18):** R10 100 Ω → 1 kΩ (with ~10 pF the RC is 10 ns, against 220 ns minimum T0H), so a fault drives only ~10 mA into the clamp. It also stops cable ringing reaching the input (§Power and data). Optional: a DNP BAT54S footprint from DIN_IN to +5V/GND (a layout change) |
| R7 | **No reverse-polarity protection.** A chain cable with pins 1 and 3 swapped (v1's connectors needed exactly that kind of cable) reverses the next light's 12 V. TVS D4 then conducts forward and crowbars the feed. With a current-limited supply nothing is hurt. With a 5 A supply, D4 heats until it fails short, and the light is dead until D4 is replaced. | dead (D4 replaced; the rest probably survives, held to −1 V by D4) | unlikely (XH is keyed, so only a mis-made cable does it) | DESIGN §1 "connector pin order", D4; D4 is unidirectional | the feed trips or sags at connection; D4 hot or shorted | accept on the board. Test every new cable with a meter; first power through a current-limited supply (bring-up); a fuse per feed (R5) |
| R8 | **Screw heads over copper.** The inner M3 holes have GND pour 1.9 mm from their centres on both layers, and a **+5V track 2.45 mm from H3** on the back. An M3 pan head (r 2.75 mm) or hex standoff (r ≈ 3.2 mm) bears on solder mask only. A scraped mask ties the housing to GND, or shorts +5V to it. Combined with **R9** below, a chafed R+ wire would put 12 V across Rs (≈ 54 A until Rs burns open). | function lost (+5V short: logic off, and DIM floats high, so full white with no control); burn if combined with R9 | unlikely | netview of both layers (2026-10-30); `pcbkit.mech` keep-outs apply only to holes outside the core | resistance from the housing to GND / +5V with the light assembled (expect open) | **nylon washers or nylon screws** on the driver (no board change). The owner confirms the housing floats and can isolate the board, so the keep-out re-route isn't needed |
| R9 | **Harness through bare aluminium.** The LED board's 6.4 mm wire hole exposes the aluminium core at its wall; MCPCB edges are often sharp. Silicone wire insulation cuts easily. One chafed wire on a floating housing does nothing; two, or one plus R8, short a channel. | dead (that channel), or a burn with R8 | possible over months | DESIGN §2.5 (6.4 mm hole, 24 AWG silicone); MCPCB construction | resistance from each harness wire to the LED board's aluminium (expect open) | a sleeve or grommet through the hole, or deburr and chamfer it; add it to PRODUCTION's harness steps |
| R10 | **Schottky D1–D3 hottest part, little margin in a warm housing.** Typical: 0.16–0.17 W, Tj ≈ 80 °C at 40 °C ambient, 95 °C at 55 °C. With the forward voltage at an inferred maximum: up to 133 °C at 55 °C, above the 125 °C Tj max. θJA is 160 °C/W only on 5 × 5 cm of copper; SOD-123 pads are estimated at 250–300 °C/W. | degraded (leakage rises ~10× by 100 °C; long-term) | possible | B5819W datasheet (Tj 125 °C, derating, θJA note); `sim/results/worst_case.txt`; DESIGN §2.7 | case temperature at full white in the closed housing: thermocouple or IR on D1 (red runs hottest) | **bench test first.** Above ~100 °C case, change to a SOD-123FL Schottky (SS14L C190475 or DSK14 C37049, 0.55 V at 1 A) on a SOD-123F footprint, with a touch-up of each cell's switching loop |
| R11 | **Rotation rules never checked in JLC's preview:** `^SOT-89` +180° (U2–U4 PT4115, U5 78L05) and `^SOT-353` +180° (U7). A PT4115 turned 180° puts 12 V on DIM (6 V abs max) and SW on CSN. | dead (smoke at first power) | possible | `PLACEMENT-driver.md` "never" rows; LAYOUT (LCSC's SOT-89-5 footprint is KiCad's turned 180°) | current-limited first power: a short or high current at once | already on PRODUCTION's checklist: check each pin-1 dot in the preview, then record the result in pcb-kit's corrections table |
| R12 | **Fail bright without 5 V.** If +5V is missing (78L05 dead, or R8), the 74HC04 is unpowered. The PT4115s' DIM inputs then float up through their internal 200 kΩ pull-ups, so all three channels run at full current with no control. | function lost (stuck at full white, inside the thermal design) | unlikely | PT4115 §7 (DIM floating = full current, R_DIM 200 kΩ) | full white at power-up, before any data; +5V at U1.8 reads 0 | accept; a diagnosis note for the bench list |
| R13 | **PWM bottom end:** levels 1–8 dim or uneven, 1–2 likely dark. 4 kHz PWM can make the ceramic caps sing. | nuisance | likely | DESIGN §2.7 Q2, Q3; PT4115 min duty 4 % at 20 kHz | brightness against level; listen at mid levels | firmware: gamma correction, keep levels below ~8 out of fades. Bench: listen |
| R14 | **Stock:** blue LED C49237860 has 704 left (green has recovered to 2,480). | nuisance | possible | bomi `list --check` 2026-10-30 | order fails at JLC | order soon after deciding, or buy a spare reel of blue |

R7–R14 can follow the first order. R1 needs its test first, and R3, R4 and R6 go in with the planned changes.

## Power and data

- **Power:** DESIGN §2.4 defines a feed (D14): 12 V, up to 5 lights, 26–28 W typical and 29–31 W worst case, 36 W supply for 4 lights plus controller, 60 W for 5. Numbers are in `sim/results/worst_case.txt`.
- **This board needs 12 V.** The PT4115 needs 6–30 V and stops below 5.1 V; the 78L05 has 1.7 V dropout, which leaves about 3.3 V from a 5 V input, under the WS2811's 3.5 V. A 5 V version would be a new driver at about 0.96 A per light, 3 lights per connector. A stepdown is fine for the controller, or from a higher supply down to 12 V.
- **Repeaters (D16):** pcb-kit's repeater is the SN74AHCT1G125, which each light already has as U7. Each WS2811 also regenerates the data, so nothing accumulates along a chain, and adding a gate on DOUT isn't needed.
- **Data over cable:** `sim/data_cable.py` drives a 250 ns T0H through R8 and a cable into R10 and U7, with assumed DO impedance and cable Z0. With R10 at 1 kΩ, every length to 8 m gives one clean edge each way, T0H about 277 ns at U7, and clamp current under 0.6 mA. With 100 Ω, the clamp takes 5–7 mA from 2 m up, so D18 also helps here. Not measured; bring-up step 6 scopes it.
- **Ground offset:** a downstream light's GND sits above its upstream neighbour's, by about 0.13 V per metre at 2.4 A in the first span. The data's low level therefore goes slightly negative at the next U7, not towards its threshold, and R10 limits that clamp current too (inferred).

## Verified OK

- **Pinouts against the datasheets, pad by pad on the board** (2026-10-30 pad dump):
  - **PT4115 SOT-89-5:** 1 SW, 2 GND (tab), 3 DIM, 4 CSN, 5 VIN. KiCad pad positions match UMW's drawing (1–3 on one side, 5/4 on the other, tab = GND).
  - **78L05G-AB3-R:** O-G-I (not the -AB3-C-R variant).
  - **SN74AHCT1G125 DCK:** 1 OE (GND), 2 A, 3 GND, 4 Y, 5 VCC.
  - **WS2811 SOP-8:** pins 1–8 as V2.2, with pin 7 NC on the DNP strap R9.
  - **74HC04:** pin 14 on +5V, unused inputs 9/11/13 to GND.
  - **Diodes:** B5819W and SMAJ15A cathodes on +12V.
  - **HD2525:** pad 1 K, pad 2 A, per its datasheet p.7.
  - **J3:** R+ R− G+ G− B+ B−.
- **PT4115 values:**
  - I_LED 422–476 mA at the corners, against 1 A LED abs max and the 0.082 Ω minimum Rs.
  - Inductor peak ≈ 0.58 A against Isat 1.1 A (×1.9; the datasheet asks 1.3–1.5×). Irms 1.3 A, DCR 376 mΩ (JLC data).
  - 68 µH is inside the datasheet's 47–68 µH band for 0.4–0.8 A.
  - Cin 10 µF 50 V 1206 X5R, above 4.7 µF at 12 V bias.
  - Schottky rated 40 V / 1 A against 12 V and ~0.35 A average (more than the datasheet's 30 % margin).
- **Voltages:**
  - The TVS clamps 24.4 V at 16 A, under the PT4115's 35 V abs max (VIN, SW) and the caps' 25/50 V.
  - The TVS's 15 V standoff is above a 12 V ± 10 % supply.
  - 78L05 dissipation 75–185 mW, against 350 mW.
- **Logic levels:**
  - AHCT VIH 2.0 V takes a 3.3 V controller.
  - The AHCT's 5 V output meets the WS2811's VIH of 0.55 × VDD.
  - DIM high 4.8–5.2 V: under the 6 V abs max. The PWM formula assumes ≤ 5 V; at 5.2 V nothing changes but the margin.
  - The WS2811 output pulls the 4.7 kΩ pull-up fully low (16 mA sink against 1.06 mA).
- **Unpowered and partial states:**
  - AHCT inputs have no clamp to VCC, so an upstream light can't back-power an unpowered one through the data line (TI datasheet; pcb-kit PARTS.md).
  - The WS2811's DIN/DO survive a momentary 24 V (V2.2 features).
  - With no controller, R7 holds DIN low.
  - v1 measured the WS2811 outputs off at power-up (DIM_x_RAW at 5 V), so DIM should be low and the light dark until data arrives. Not settled, given v1's faults: check at bring-up step 3.
  - If data stops, the WS2811 holds its last frame (V2.2). Full white held indefinitely is inside the thermal design (§2.6).
- **Harness faults (from the topology, inferred):**
  - J3 unplugged under power: no current path, so the switch just stays on. Plugging back in ramps through L.
  - LED shorted: the channel still regulates through L.
- **Copper:**
  - The 12 V trunk is 1.5 mm of 1 oz, ≈ 3.2 A at a 10 °C rise (IPC-2221), with full-width stubs to J1.1/J2.1.
  - The GND pass-through is the pours on both layers. The back pour is split down the middle by the logic runs, but its halves join round the bottom and through the front pour (netview).
  - The mounting holes are unplated (NPTH), so no copper connects to the screws.
- **Checks on 2026-10-29:** ERC 0, DRC 0/0 with parity 0 on both boards, `netcheck.py` 0 failures, `pcbkit check` clean (thin feeds explained in LAYOUT.md), `pcbkit release --dry-run` passes.

## Test points and rework provisions

The driver has no test points, and its vias are tented. Most nets can still be probed at a part's pin:
- **SW:** the inductor or diode pads.
- **CSN and current:** across Rs (1206): 100 mV = 455 mA.
- **DIN_5V and the WS2811 outputs:** the SOIC pins of U1.
- **DIM:** the 74HC04 pins.
- **+5V:** at C1 to C4.

| Net or part | Why | Where | Footprint |
| --- | --- | --- | --- |
| one via each of `/DIN_5V`, `/DOUT`, `/OUT_R/G/B`, `/DIM_R/G/B`, `+5V`, `+12V`, next to a GND via | probe from the back with the board on its standoffs (R2, R4, R12) | existing vias on B.Cu, tenting turned off for those vias only | none (per-via tenting in KiCad 10) — free |
| R9 (DNP, 0 Ω, SET to +5V) | already there for R2 | U1 pin 7 | 0402 |
| Rs R1–R3 | lower current for a first light, or without a heatsink (0.33 / 0.47 Ω) | 1206, easy to swap | — |
| Rd for the WS2811 (R3) | only if v1 shows zener current | between +5V and U1.8 | 0402, would need a re-route |
| left out: a pad on SW for a scope ground spring | the inductor pads take a probe tip, and C6–C8's GND pads sit beside them; no room in the cells | | |

## Bench list

**Before ordering:** diode-test a v1 LED for its polarity (R1). It tests the part, so v1's faults don't matter. Everything else moves to v2 bring-up, because v1 results can't be relied on.

**v2 bring-up, per board:**
1. **Inspect:** LED polarity against the "+" marks (R1); the pin-1 dots of U1–U7 (R11); D1–D4 bands.
2. **Unpowered:** resistance from +12V to GND (≫ 1 kΩ once C6–C9 have charged from the meter) and from +5V to GND. From the housing / mounting screws to GND and +5V: open (R8). From each harness wire to the LED board's aluminium: open (R9).
3. **First power:** 12 V from a supply limited to 0.15 A, with no data and J3 plugged in. Expect:
   - +5V = 4.8–5.2 V at U1.8;
   - the light dark;
   - less than 30 mA drawn.

   If all three colours light at full, check +5V (R12).
4. **One colour at a time:** raise the limit to 0.6 A and send one colour at 255, at 800 kHz with a ≥ 500 µs gap. Expect about 100 mV across that colour's Rs and about 0.15 A drawn. Scope DIM_x at a PWM edge for chatter (R4).
5. **Full white, closed housing, 30 min:**
   - 0.42 A per light;
   - D1's case temperature (R10);
   - J2's temperature on the first light of a chain;
   - listen for singing (R13).
6. **Chain:** two lights with a pin-1-to-pin-1 XH cable (tested with a meter first), then 5 on one feed at full white. Scope U7 pin 2 on the longest cable.
7. **Brightness against level (0–32):** for a gamma table (R13).

## Firmware duties

Checked against V2.2 on 2026-10-31, using FastLED master (`fl/chipsets/led_timing.h`) and ESPHome dev (`esp32_rmt_led_strip/light.py`). Other versions may differ.

| Driver | T0H / T0L | T1H / T1L | Reset | Against V2.2 (T0H 220–380; others 580–1000 ns; reset ≥ 280 µs) |
| --- | --- | --- | --- | --- |
| FastLED `WS2811` | 250 / 1000 ns | 600 / 650 ns | 280 µs | inside, T0L and reset exactly at the limit |
| FastLED `WS2811_400` | 500 / 2000 ns | 1200 / 1300 ns | 280 µs | outside: don't use |
| ESPHome `chipset: WS2811` | 300 / 1090 ns | 1090 / 320 ns | 300 µs | **outside:** T0L and T1H long, T1L short |
| ESPHome custom timing (below) | 300 / 950 ns | 650 / 600 ns | 300 µs | inside |

- **FastLED:** use `WS2811`, and leave a gap (`delayMicroseconds(500)`) if frames are sent back to back. Nothing was measured on hardware.
- **Home Assistant, assuming ESPHome on an ESP32:** leave `chipset` out of `esp32_rmt_led_strip` and set the timing. WLED was not checked.

  ```yaml
  bit0_high: 300ns
  bit0_low: 950ns
  bit1_high: 650ns
  bit1_low: 600ns
  reset_low: 300us
  ```
- **Colour order:** R, G, B, MSB first. No inversion in software: the 74HC04 already makes 255 = full.
- **Gamma correction:** keep levels below ~8 out of fades (R13).
- **Power budget:** up to 5.51 W per light at full white in the worst case, 5 lights per feed (DESIGN §2.4).

## Answers (owner, 2026-10-31)

1. **v1 bench tests:** can't be relied on; v1 had too many faults. PWM from the chip is recalled on a scope, not measured for this review (R2).
2. **Housing:** connected to nothing, and it can isolate the board as needed (R8, R9).
3. **Controller:** FastLED, and Home Assistant addressable lights (firmware duties).
4. **Supply:** the "5 V" answer was a mix-up. The design point is 4–5 lights per chain, with power injection for longer chains, and a fuse per feed (§Power and data).

Accepted: R3, R4, R5, R6, R8, R9 and the silk mark in R1 (DESIGN D14–D20).

## Questions for the user

Open, also in `HANDOVER.md`:
1. Which outline preset fits the housing, and do the back-cap cut-outs line up with J1/J2?
2. For Home Assistant, ESPHome (timing above) or WLED (not checked)?
3. Should one via per key net be untented for test access (§Test points)?

## Not covered

- **EMI** from the 200–250 kHz LED wires and SW nodes: no measurement or simulation.
- **Thermal:**
  - the housing's air temperature is assumed at 40–55 °C, not measured;
  - the LED junctions rest on DESIGN §2.6's estimate.
- **KiCadRoutingTools' checkers** (LAYOUT.md) not run.
- **PT4115 model:** behavioural only (DESIGN §2.7). Start-up delay, saturation and SW parasitics are left out.
- **Mechanical:** vibration, wire strain at the LED pads, the back-cap cut-outs over J1/J2.
- **Second-pass refutation:** no independent pass. The datasheet claims above were re-read against the source text (WS2811 V2.2, UMW PT4115 Jul 2025, TI SN74AHCT1G125, Nexperia 74HC04, XINGLIGHT HD2525 p.7, MDD B5819W).
