somebox/rgb-spotlight/docs/datasheets/74HC04D,653_C5590.md

# 74HC04D,653 (C5590)

**Manufacturer:** Nexperia  
**Package:** SOIC-14  
**Category:** Inverters  
**Datasheet:** https://www.lcsc.com/datasheet/lcsc_datasheet_2407241044_Nexperia-74HC04D-653_C5590.pdf  
**JLCPCB:** https://jlcpcb.com/partdetail/Nexperia-74HC04D653/C5590  

---

# Nexperia 74HC04D,653 — Hex Inverter Technical Summary

## Overview
Six independent single-input inverters (NOT gates) in a 14-pin SOIC package. CMOS logic family with wide supply voltage range.

---

## Key Specifications

| Parameter | Value |
|---|---|
| Supply Voltage (V_CC) | **2.0 V – 6.0 V** (recommended); –0.5 V to +7 V absolute max |
| Operating Temperature | **–40°C to +125°C** |
| Input Leakage Current (I_I) | ±1 µA max @ V_CC = 6.0 V |
| Output Current (I_OH / I_OL) | **±5.2 mA** @ V_CC = 6.0 V; ±4.0 mA @ 4.5 V |
| Max Output Current (I_O) | ±25 mA absolute max |
| Supply Current (I_CC, static) | 40 µA max @ 125°C |
| Propagation Delay (t_pd) | **14 ns max** @ V_CC = 6.0 V, C_L = 50 pF, 125°C |
| Propagation Delay (t_pd) | 22 ns max @ V_CC = 6.0 V, –40°C to +125°C |
| Input Capacitance (C_I) | 3.5 pF typical |
| Power Dissipation Capacitance (C_PD) | 21 pF typical (per package) |
| Max Power Dissipation (P_tot) | **500 mW** (SOIC-14, SOT108-1) |
| ESD Protection (HBM) | >2000 V |
| ESD Protection (CDM) | >1000 V |

### Input Logic Thresholds (74HC04 @ V_CC = 5.0 V nominal)

| Parameter | V_CC = 2.0 V | V_CC = 4.5 V | V_CC = 6.0 V |
|---|---|---|---|
| V_IH min | 1.5 V | 3.15 V | 4.2 V |
| V_IL max | 0.5 V | 1.35 V | 1.8 V |
| V_OH min (full load) | 1.9 V | 3.7 V | 5.2 V |
| V_OL max (full load) | 0.1 V | 0.4 V | 0.4 V |

---

## Pin Descriptions (SOIC-14)

| Pin | Symbol | Type | Description |
|-----|---|---|---|
| **1** | 1A | Input | Inverter 1 input |
| **2** | 1Y | Output | Inverter 1 output |
| **3** | 2A | Input | Inverter 2 input |
| **4** | 2Y | Output | Inverter 2 output |
| **5** | 3A | Input | Inverter 3 input |
| **6** | 3Y | Output | Inverter 3 output |
| **7** | GND | Power | Ground (0 V) |
| **8** | 4Y | Output | Inverter 4 output |
| **9** | 4A | Input | Inverter 4 input |
| **10** | 5Y | Output | Inverter 5 output |
| **11** | 5A | Input | Inverter 5 input |
| **12** | 6Y | Output | Inverter 6 output |
| **13** | 6A | Input | Inverter 6 input |
| **14** | V_CC | Power | Supply voltage |

---

## Truth Table

| Input (nA) | Output (nY) |
|---|---|
| LOW | HIGH |
| HIGH | LOW |

---

## Typical Application Circuit

```
        V_CC (2.0V – 6.0V)
          |
         [C1] 100nF  ← Bypass capacitor (ceramic, place close to pin 14)
         [C2] 10µF   ← Bulk capacitor (electrolytic, per board section)
          |
    Pin 14 (VCC) ─────┤
    Pin 7  (GND) ─────┴──── GND

    Signal Input
       │
      [R1] 1kΩ – 10kΩ  ← Current limiting resistor (if V_IN > V_CC)
       │
    Pin 1 (1A) ──► Pin 2 (1Y) → Inverted Output
                               [R_T] = Z0 of source (e.g. 50Ω) to GND (test/termination)
                               [C_L] ≤ 50 pF load capacitance
```

### Oscillator / Clock Buffer Example
```
    ┌──────────────────────────┐
    │   [R_F] 1MΩ (feedback)   │
    │  ┌────────────────┐      │
    └──┤ Pin 1 (1A) → Pin 2(1Y)├── Buffer Chain (gates 2, 3)
       └────────────────┘
         [C_X] Crystal or RC network between input/output
         R_S = 100Ω – 1kΩ series resistor on output (EMI reduction)
```

---

## Design Notes & Limitations

> ⚠️ **Critical Design Considerations**

1. **Decoupling**: Place 100 nF ceramic capacitor as close as possible to pin 14 (V_CC) and pin 7 (GND). Add 10 µF bulk capacitor per power rail section.

2. **Input Overdrive Protection**: Inputs include internal clamp diodes. Use a **current-limiting resistor (1 kΩ typical)** when input voltages may exceed V_CC or go below GND to keep clamping current below ±20 mA absolute max.

3. **Unused Inputs**: **Never leave inputs floating.** Tie unused gate inputs to V_CC or GND through a resistor (10 kΩ typical) to prevent oscillation and excess I_CC.

4. **Input Transition Rate**: Slow input signals (>139 ns/V @ 4.5 V) may cause oscillation or increased power dissipation. Add a Schmitt-trigger buffer upstream if input edges are slow.

5. **Output Drive**: Maximum sustained output current is **±25 mA per pin** (absolute max). Do not exceed **±5.2 mA** under normal operating conditions at 6 V.

6. **Power Dissipation Derating**: SOIC-14 (SOT108-1) P_tot derates at **10.1 mW/°C above 100°C**. At 125°C: P_tot_max ≈ 500 − (10.1 × 25) = **247.5 mW**.

7. **Latch-Up Immunity**: Exceeds 100 mA per JESD 78 Class II Level B — robust against transient overcurrent events.

8. **74HC vs 74HCT**: This part is **74HC04** (CMOS-level inputs). The 74HCT04 variant accepts TTL-level inputs (V_IH = 2.0 V min) and requires 4.5 V–5.5 V supply only. Do **not** mix the two variants without verifying input thresholds.

9. **High-Frequency Use**: At 6 V with 50 pF load, propagation delay is 14 ns (max, 125°C). For faster switching, reduce C_L or increase V_CC within rated range.
