somebox/rgb-spotlight/docs/datasheets/B5819W_C64885.md

# B5819W (C64885)

**Manufacturer:** MDD(Microdiode Semiconductor)  
**Package:** SOD-123  
**Category:** Schottky Diodes  
**Datasheet:** https://www.lcsc.com/datasheet/lcsc_datasheet_2407291648_MDD-Microdiode-Semiconductor-B5819W_C64885.pdf  
**JLCPCB:** https://jlcpcb.com/partdetail/MDD_Microdiode_Semiconductor-B5819W/C64885  

---

# B5819W Schottky Diode — Technical Summary

**Manufacturer:** MDD (Microdiode Semiconductor) | **Part (C64885)** | **Marking:** SL

---

## Key Specifications

| Parameter | Value |
|---|---|
| Max Repetitive Peak Reverse Voltage (V_RRM) | **40 V** |
| Max RMS Voltage (V_RMS) | 28 V |
| Average Rectified Output Current (I₀) | **1.0 A** |
| Continuous Forward Current (I_FRM) | 1.5 A |
| Non-Repetitive Peak Surge Current (I_FSM, 8.3 ms) | **25 A** |
| Forward Voltage @ 1 A (typ / max) | 0.60 V / 0.90 V |
| Reverse Breakdown Voltage @ I_R = 1 mA | 40 V |
| Reverse Leakage Current @ V_R = 40 V, 25°C | **1.0 mA** |
| Reverse Leakage Current @ V_R = 40 V, 100°C | 10.0 mA |
| Junction Capacitance (C_j, typ) | 110 pF |
| Power Dissipation (P_D) | 500 mW |
| Thermal Resistance (R_θJA)¹ | 160 °C/W |
| Operating / Storage Temperature (T_j, T_stg) | **−55°C to +125°C** |

> ¹ Measured with 5 cm × 5 cm copper pad area on PCB.

---

## Package & Pin Description

**Package:** SOD-123 (2-pin SMD)

| Pin | Label | Description |
|---|---|---|
| **Pin 1** (Cathode end) | **K** | Cathode — marked with bar on package body |
| **Pin 2** (Anode end) | **A** | Anode |

> **Polarity identification:** The cathode bar is clearly marked on the top of the molded body. Anode is on the opposite lead.

---

## Typical Application Circuit

### Half-Wave Rectifier / Reverse-Polarity Protection

```
        D1 (B5819W)
VIN ───►|────── VOUT
  (Anode→Cathode)
                │
               [C1]   [R_Load]
                │        │
               GND ─────GND
```

| Component | Recommended Value | Notes |
|---|---|---|
| Input Voltage | ≤ 40 V DC/peak | Must not exceed V_RRM |
| Load Current | ≤ 1.0 A continuous | Derate above 25°C |
| Output Filter Cap (C1) | 10–100 µF | Application dependent |
| Snubber Cap (optional) | 100 pF | Across diode for EMI suppression |
| PCB Copper Pour | ≥ 5 cm × 5 cm | Required to achieve rated P_D |

---

## PCB Footprint (Suggested Pad Layout)

| Symbol | mm | inch |
|---|---|---|
| Pad width (A) | 1.2 | 0.047 |
| Pad height (B) | 1.2 | 0.047 |
| Pad center-to-center (C) | 3.2 | 0.126 |
| Gap between pads (D) | 2.0 | 0.079 |
| Overall courtyard length (E) | 4.4 | 0.173 |

---

## Important Design Notes & Limitations

- **Power Derating:** P_D derates linearly from 500 mW at 25°C to **0 mW at 125°C**. At 85°C ambient, maximum allowable dissipation is approximately ~250 mW.
- **Leakage Temperature Sensitivity:** Reverse leakage (I_R) increases by **~10× from 25°C to 100°C** — critical for high-temperature applications and battery circuits.
- **Junction Capacitance:** C_j = 110 pF (typ) at zero bias; drops sharply with reverse voltage. Limits use in high-frequency switching above ~50 MHz.
- **Surge Handling:** 25 A peak surge is rated at **8.3 ms (single pulse)** only — not repetitive.
- **Not for life-support systems** without express written approval from the manufacturer.
- **Thermal Management:** The 160°C/W R_θJA rating is **only valid with a 5×5 cm copper pad**; smaller pads will significantly increase junction temperature.
- **Forward Voltage Caution:** Maximum V_F at 1 A is **0.90 V** (significantly higher than typical 0.60 V) — use max value for worst-case power loss budgeting.
