somebox/rgb-spotlight/docs/datasheets/FNR6045S101MT_C168095.md

# FNR6045S101MT (C168095)

**Manufacturer:** cjiang (Changjiang Microelectronics Tech)  
**Package:** SMD,6x6mm  
**Category:** Power Inductors  
**Datasheet:** https://www.lcsc.com/datasheet/lcsc_datasheet_2304140030_cjiang--Changjiang-Microelectronics-Tech-FNR6045S101MT_C168095.pdf  
**JLCPCB:** https://jlcpcb.com/partdetail/179478-FNR6045S101MT/C168095  

---

# FNR6045S101MT — Technical Summary

## Component Overview
**Changjiang Microelectronics (cjiang) Wire Wound SMD Power Inductor**
- **Series:** FNR6045S
- **Part Decode:** FNR | 6045 | S | 101 | M | T
  - 6045 = 6.0×6.0×4.5mm body
  - S = Standard
  - 101 = 100μH
  - M = ±20% tolerance
  - T = Tape & Reel

---

## Key Specifications

| Parameter | Value |
|---|---|
| Inductance | 100 μH ±20% |
| Test Frequency | 100 kHz, 1V |
| DCR (Typical) | 433 mΩ |
| DCR (Maximum) | 563 mΩ |
| Saturation Current (Isat, Typ) | 1.00 A |
| Saturation Current (Isat, Max) | 0.95 A |
| Rated RMS Current (Irms, Typ) | 880 mA |
| Rated RMS Current (Irms, Max) | 800 mA |
| Self-Resonant Frequency (SRF) | 4.2 MHz (min) |
| Operating Temperature | −40°C to +125°C (including self-heating) |
| Package | SMD, 6.0×6.0×4.5mm |

> **Note on current ratings:**
> - **Isat** = DC current causing ~30% inductance drop from no-load value
> - **Irms** = DC current causing ΔT = +40°C from 25°C ambient

---

## Pin Description

This is a **2-terminal passive inductor** (no polarity). Terminals are SMD metallized pads on opposing sides of the ferrite core body.

| Terminal | Description |
|---|---|
| **Pin 1** (Pad 1) | Inductor terminal A — connect to circuit node |
| **Pin 2** (Pad 2) | Inductor terminal B — connect to circuit node |

> Inductors are non-polarized; either terminal may be used as input or output.

### Package Dimensions (FNR6045S)

| Dimension | Value |
|---|---|
| A (Length) | 6.0 ±0.3 mm |
| B (Width) | 6.0 ±0.3 mm |
| C (Height) | 4.5 mm max |
| D (Pad span) | 4.9 ±0.3 mm |
| E (Pad height) | 1.55 ±0.3 mm |
| F (Pad pitch) | 2.9 ±0.3 mm |
| Land pad A (Typ) | 2.8 mm |
| Land pad B (Typ) | 1.7 mm |
| Land pad C (Typ) | 5.7 mm |

---

## Typical Application Circuit

### DC-DC Buck Converter (e.g., synchronous buck)

```
VIN ─────┬─────────────────────────────┐
         │                             │
       [Q1]  (High-side FET)           │
         │                             │
         ├──── SW node ────[L1: 100μH]──┬── VOUT
         │                             │
       [Q2]  (Low-side FET)          [COUT]
         │                             │
GND ─────┴─────────────────────────────┘
```

**Recommended companion component values for ~1A, 5V→3.3V, 500kHz:**

| Component | Value |
|---|---|
| L1 (this device) | 100 μH |
| CIN (input cap) | 10–22 μF, ceramic |
| COUT (output cap) | 22–47 μF, ceramic |
| Switching frequency | ≤500 kHz (SRF = 4.2 MHz, keep f << SRF) |
| Max continuous load | ≤880 mA (derate to Irms limit) |

---

## Important Design Notes & Limitations

1. **Current Derating:**
   - Do **not** exceed Irms (880 mA typ) for continuous DC load — this is the thermal limit (ΔT = 40°C).
   - Do **not** exceed Isat (1.0 A typ) for peak/transient currents — inductance collapses by ~30% above this, risking inductor and converter instability.
   - Use the **lower** of Isat and Irms as the design current limit.

2. **Frequency Limitation:**
   - SRF minimum is **4.2 MHz**. Operating frequency should be **well below SRF** (typically ≤1/10th SRF = ≤420 kHz) to ensure inductive behavior.

3. **Inductance Tolerance:**
   - ±20% tolerance must be accounted for in converter stability and ripple calculations. Actual inductance range: **80–120 μH**.

4. **DCR Power Loss:**
   - At 880 mA, DCR loss ≈ (0.880)² × 0.433 Ω ≈ **335 mW** — verify PCB thermal handling.

5. **Temperature:**
   - Max operating temperature is 125°C **inclusive of self-heating**. In high-ambient environments, derate current accordingly.

6. **Magnetic Shielding:**
   - Closed magnetic circuit (magnetic-resin shielded) design minimizes EMI and stray flux coupling to adjacent circuits.

7. **Reflow Compatibility:**
   - Tape & Reel (T suffix) packaging — suitable for automated SMT pick-and-place assembly. Follow standard SMD reflow profiles.

8. **PCB Land Pattern:**
   - Use recommended land pattern per Fig.2 in datasheet (A=2.8mm, B=1.7mm, C=5.7mm) for optimal solder joint and thermal performance.
