somebox/rgb-spotlight/docs/datasheets/SN74AHCT1G125DCKR_C350557.md

# SN74AHCT1G125DCKR (C350557)

**Manufacturer:** Texas Instruments  
**Package:** SC-70-5  
**Category:** Buffers, Drivers, Receivers, Transceivers  
**Datasheet:** https://www.lcsc.com/datasheet/lcsc_datasheet_1912111437_Texas-Instruments-SN74AHCT1G125DCKR_C350557.pdf  
**JLCPCB:** https://jlcpcb.com/partdetail/TexasInstruments-SN74AHCT1G125DCKR/C350557  

---

# SN74AHCT1G125DCKR — Single Bus Buffer Gate with 3-State Output

## Key Specifications

| Parameter | Value |
|---|---|
| Supply Voltage (V_CC) | 4.5V – 5.5V |
| Input High Voltage (V_IH) | ≥ 2.0V (TTL compatible) |
| Input Low Voltage (V_IL) | ≤ 0.8V |
| Output Drive Current (I_OH / I_OL) | ±8 mA |
| Max Quiescent Current (I_CC) | 10 µA @ 5.5V |
| Propagation Delay (t_pd) | 5.5 ns max @ 5V, 15pF (–40°C to 85°C: 6.5 ns max) |
| Enable/Disable Time (t_PZH/t_PZL) | 6.0 ns max @ 5V, 15pF |
| Hi-Z Disable Time (t_PHZ/t_PLZ) | 8.0 ns max @ 5V, 15pF |
| Operating Temperature | –40°C to +125°C |
| Package | SC-70-5 (DCK), 2.00mm × 1.30mm |
| ESD Protection (HBM) | 1000V |

---

## Pin Descriptions (DCK SC-70-5 Package)

| Pin # | Name | Type | Description |
|---|---|---|---|
| 1 | /OE | Input | Output Enable, **active LOW**; HIGH = Hi-Z output |
| 2 | A | Input | Data input |
| 3 | GND | Power | Ground reference |
| 4 | Y | Output | 3-state buffered output |
| 5 | V_CC | Power | Supply voltage (4.5V–5.5V) |

---

## Function Table

| /OE | A | Y |
|-----|---|---|
| L | H | H |
| L | L | L |
| H | X | **Z** (Hi-Z) |

---

## Typical Application Circuit

**3.3V → 5V Logic Level Translation:**

```
3.3V Logic ──────────── A (Pin 2)
                        SN74AHCT1G125
Control ─────────────── /OE (Pin 1)
                        Y (Pin 4) ──── 5V Logic/Load
GND ────────────────── GND (Pin 3)
5V ──┬──────────────── VCC (Pin 5)
     │
    C1 (100nF, X5R/X7R, placed ≤1mm from Pin 5)
     │
    GND
```

**Recommended bypass capacitor:** 100 nF ceramic (0.1µF) in parallel with optional 1µF for broadband noise rejection, placed as close as possible to Pin 5.

**OE pull-up resistor** (for defined state during power-up/power-down):
- Tie /OE to V_CC via 10kΩ–100kΩ pull-up resistor to ensure Hi-Z during power transitions.

---

## Important Design Notes

- **TTL-compatible inputs** allow direct interfacing from 3.3V logic to 5V systems (V_IH = 2.0V min).
- **All unused inputs must be tied** to V_CC or GND — floating inputs cause undefined states and excessive I_CC.
- **Maximum continuous output current:** ±25 mA per pin; do not exceed ±50 mA total device current.
- **Avoid bus contention:** CMOS balanced drive can exceed absolute maximum current limits if outputs are shorted.
- **Input transition rate** must not exceed 20 ns/V (ΔI/ΔV limit) to meet timing specifications.
- **Output voltage must not exceed V_CC**; pulling Y above V_CC is prohibited.
- **Thermal note (DCK package):** θ_JA = 287.6°C/W — at 125°C ambient, power dissipation must be carefully managed.
- **MSL Rating:** Level-1-260°C-UNLIM (no bake required before soldering).
- ROHS compliant, Green (no Sb/Br), CU NIPDAU finish.
