somebox/rgb-spotlight/docs/datasheets/WS2811_C114581.md

# WS2811 (C114581)

**Manufacturer:** Worldsemi  
**Package:** SOP-8  
**Category:** LED Drivers  
**Datasheet:** https://www.lcsc.com/datasheet/lcsc_datasheet_1810081420_Worldsemi-WS2811_C114581.pdf  
**JLCPCB:** https://jlcpcb.com/partdetail/Worldsemi-WS2811/C114581  

---

# WS2811 — Single-Wire 3-Channel Constant-Current LED Driver IC

**Manufacturer:** Worldsemi | **Package:** SOP-8 / MSOP-8 / FSOP-8 | **RoHS Compliant**

---

## Key Specifications

| Parameter | Value |
|---|---|
| Logic Supply Voltage (VDD) | 3.5 V – 5.7 V |
| LED Supply Voltage (VOUT rails) | 5 V – 24 V (max 20 V on OUT pins) |
| DIN Pin Max Voltage | 9.5 V |
| Output Current per Channel (typ) | **16.0 mA** (min 14.0 mA, max 18.0 mA) |
| Channel-to-Channel Current Mismatch | ≤ 0.8 mA |
| Quiescent Current | 0.3 mA (typ) |
| PWM Resolution | 8-bit (256 levels) |
| PWM Scan Frequency | 4 kHz |
| Data Rate | 600 Kbps min, **800 Kbps** typ |
| Internal Oscillator | 800 kHz |
| Operating Temperature | **−40 °C to +85 °C** |
| Storage Temperature | −40 °C to +105 °C |
| Logic Input High (VIH) | ≥ 0.55 × VDD |
| Logic Input Low (VIL) | ≤ 0.30 × VDD |
| Input Hysteresis | 0.35 V (typ) |
| RESET Low Time | ≥ 280 µs |

---

## Pin Descriptions (SOP-8)

| Pin # | Symbol | Function |
|---|---|---|
| 1 | OUTR | Red channel constant-current PWM output (open-drain, max 20 V) |
| 2 | OUTG | Green channel constant-current PWM output (open-drain, max 20 V) |
| 3 | OUTB | Blue channel constant-current PWM output (open-drain, max 20 V) |
| 4 | GND | Signal and power ground |
| 5 | DO | Serial data output — cascaded to next IC's DIN |
| 6 | DIN | Serial data input from MCU or previous IC's DO (max 9.5 V) |
| 7 | NC | No connect |
| 8 | VDD | Logic supply (3.5 V – 5.7 V); connect via series resistor Rd from LED supply rail |

---

## Serial Protocol — Timing

| Symbol | Condition | Min | Max |
|---|---|---|---|
| T0H | Logic-0 high time | 220 ns | 380 ns |
| T0L | Logic-0 low time | 580 ns | 1 µs |
| T1H | Logic-1 high time | 580 ns | 1 µs |
| T1L | Logic-1 low time | 580 ns | 1 µs |
| T_RES | Reset (low) duration | 280 µs | — |
| t_PLZ | DIN → DO propagation delay | — | 300 ns |

**24-bit data order:** `R[7:0]` → `G[7:0]` → `B[7:0]`, MSB first.

---

## Typical Application Circuit Component Values

| Supply Voltage | LEDs per Channel | Rd (VDD series resistor) | Ci (VDD decoupling) |
|---|---|---|---|
| **5 V** | 1 LED | **150 Ω** | **1 µF** |
| **12 V** | 3 LEDs (series) | **4.7 kΩ** | **1 µF** |
| **24 V** | 6 LEDs (series) | **10 kΩ** | **1 µF** |

> **Note:** At 24 V, additional current-setting resistors (240 Ω × 3, 560 Ω × 1) are placed in series with each OUT pin to set channel current correctly.

---

## Design Notes & Limitations

- **VDD must be derived from the LED supply via Rd.** The internal zener eliminates the need for an external regulator for supplies ≤ 24 V.
- **DIN is clamped to 9.5 V max.** Do not drive DIN directly from a 12 V or 24 V logic source; use a level-appropriate MCU (3.3 V / 5 V logic).
- **OUTR/G/B pins withstand up to 20 V** and include built-in short-circuit and over-voltage protection; a momentary short to 24 V will not destroy the output stage.
- **Data reshaping on every node:** Each cascaded IC regenerates and re-transmits the waveform, eliminating cumulative signal distortion. Point-to-point interconnect may be up to **4 m** without additional buffering.
- **Maximum cascade depth:** ≥ 1024 nodes at 30 frames/second refresh.
- **RESET must be asserted (DIN low ≥ 280 µs)** to latch and apply new PWM data to outputs; outputs hold their last value until RESET is received.
- **Channel outputs have staggered turn-on** to reduce simultaneous switching noise and power-supply ripple.
- **No external oscillator required** — internal 800 kHz RC oscillator is used.
- Place **Ci (1 µF) as close as possible to pin 8 (VDD)** to suppress supply transients during switching.
