somebox/rgb-spotlight/archive/v1-easyeda/v1-netlist.txt

# v1 (EasyEDA, Mar 2026) as-built netlist, extracted from the PCB export's pad nets.
# Pin numbers are footprint pads. See DESIGN.md §1 for the faults.

## Components
C1    C1525      CL05B104KO5NNNC
C2    C1525      CL05B104KO5NNNC
C3    C1525      CL05B104KO5NNNC
C4    C1525      CL05B104KO5NNNC
C5    C15850     CL21A106KAYNNNE
C6    C15850     CL21A106KAYNNNE
C7    C15850     CL21A106KAYNNNE
C8    C15850     CL21A106KAYNNNE
D1    C64885     B5819W
D2    C64885     B5819W
D3    C64885     B5819W
J1    C265101    S3B-PH-SM4-TB(LF)(SN)
J2    C265101    S3B-PH-SM4-TB(LF)(SN)
L1    C168095    FNR6045S101MT
L2    C168095    FNR6045S101MT
L3    C168095    FNR6045S101MT
LED1  C49237857  XL-HD2525SURC-A4
LED2  C49237859  XL-HD2525UGC-A4
LED3  C49237860  XL-HD2525UBC-A4
R1    C247160    0805W8F220LT5E
R2    C247160    0805W8F220LT5E
R3    C247160    0805W8F220LT5E
R4    C25900     0402WGF4701TCE
R5    C25900     0402WGF4701TCE
R6    C25900     0402WGF4701TCE
R7    C25744     0402WGF1002TCE
U1    C114581    WS2811
U2    C347356    PT4115
U3    C347356    PT4115
U4    C347356    PT4115
U5    C71136     78L05G-AB3-R
U6    C5590      74HC04D,653
U7    C350557    SN74AHCT1G125DCKR

## Nets
+5V          C2.2 U6.14
12V          C5.2 C6.2 C7.2 C8.2 J1.1 J2.3 R1.2 R2.2 R3.2 U2.5 U3.5 U4.5 U5.3
5V           C1.2 C3.2 C4.2 R4.1 R5.1 R6.1 U1.8 U5.1 U7.5
<no net>     LED1.3 LED2.3 LED3.3 U1.7 U6.10 U6.12 U6.8
DIM_B        U4.3 U6.2
DIM_B_RAW    R4.2 U1.3 U6.1
DIM_G        U3.3 U6.4
DIM_G_RAW    R5.2 U1.2 U6.3
DIM_R        U2.3 U6.6
DIM_R_RAW    R6.2 U1.1 U6.5
DIN          J1.2 U7.2
DIN_5V       U1.6 U7.4
DOUT         J2.2 U1.5
GND          C1.1 C2.1 C3.1 C4.1 C5.1 C6.1 C7.1 C8.1 D1.2 D2.2 D3.2 J1.3 J2.1 LED1.1 LED2.1 LED3.1 R7.1 U1.4 U2.2 U3.2 U4.2 U5.2 U6.11 U6.13 U6.7 U6.9 U7.3
L1_2         D1.1 L1.2 U2.1
LED1_2       L1.1 LED1.2
LED2_2       L2.1 LED2.2
LED3_2       L3.1 LED3.2
R1_1         R1.1 U2.4
U3_1         D2.1 L2.2 U3.1
U3_4         R2.1 U3.4
U4_1         D3.1 L3.2 U4.1
U4_4         R3.1 U4.4
U7_1         R7.2 U7.1
