somebox/rgb-spotlight/docs/previews/driver/pcb-back.png

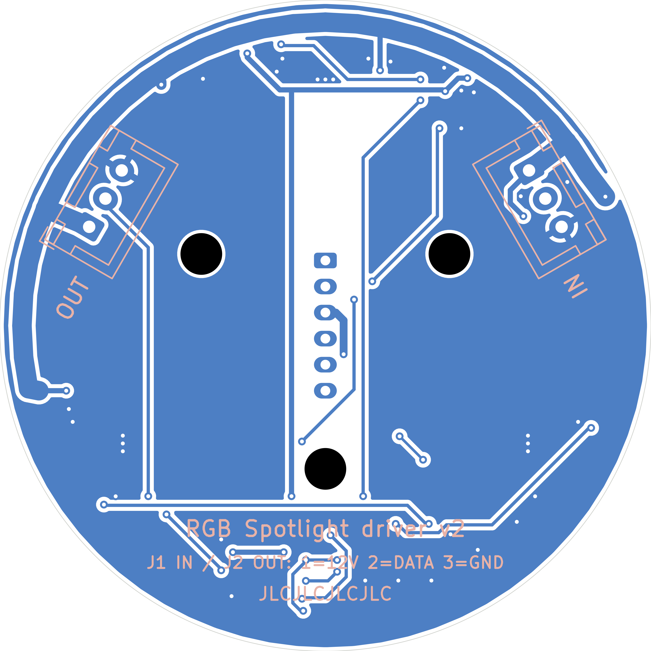
docs/previews/driver/pcb-back.png
