somebox/rgb-spotlight/docs/previews/driver/pcb-front.png

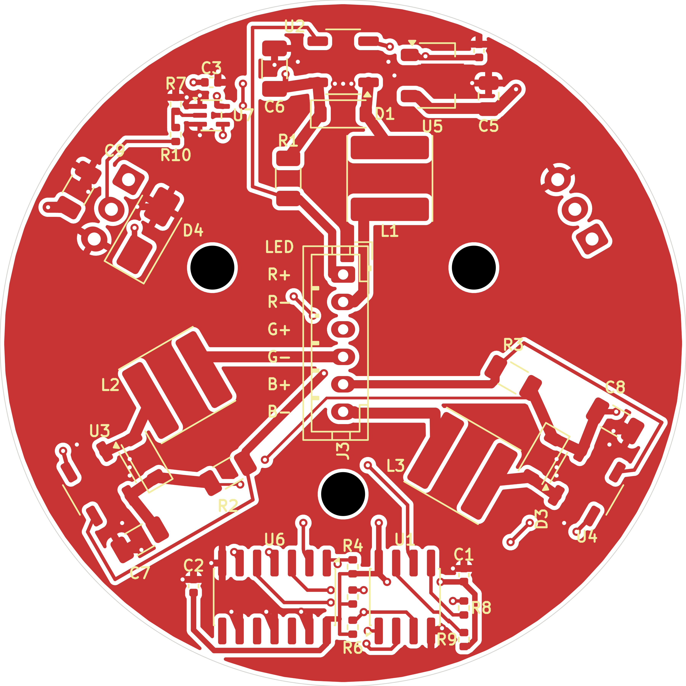
docs/previews/driver/pcb-front.png
