somebox/rgb-spotlight/docs/previews/driver/placement-ratsnest.png

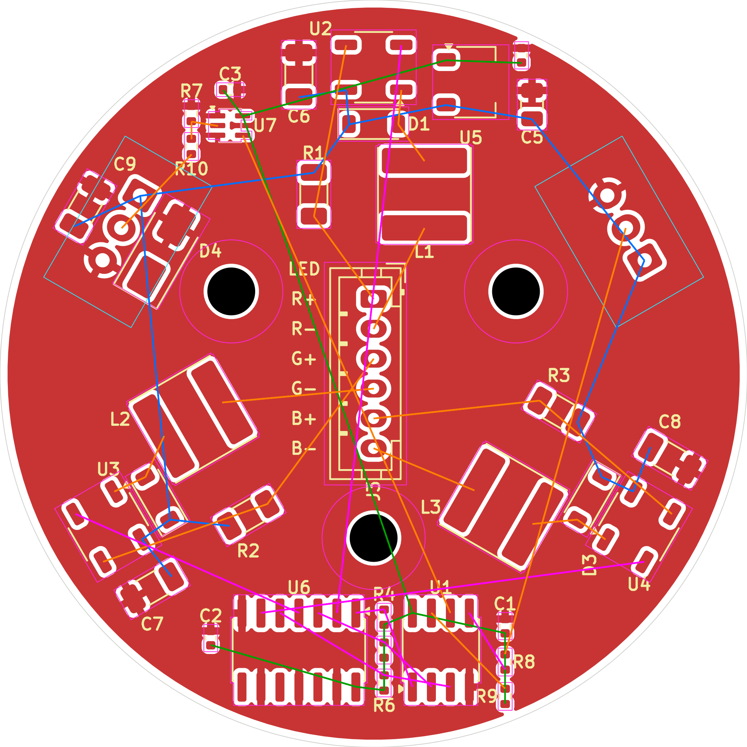
docs/previews/driver/placement-ratsnest.png
