somebox/rgb-spotlight/docs/previews/driver/render-bottom.png

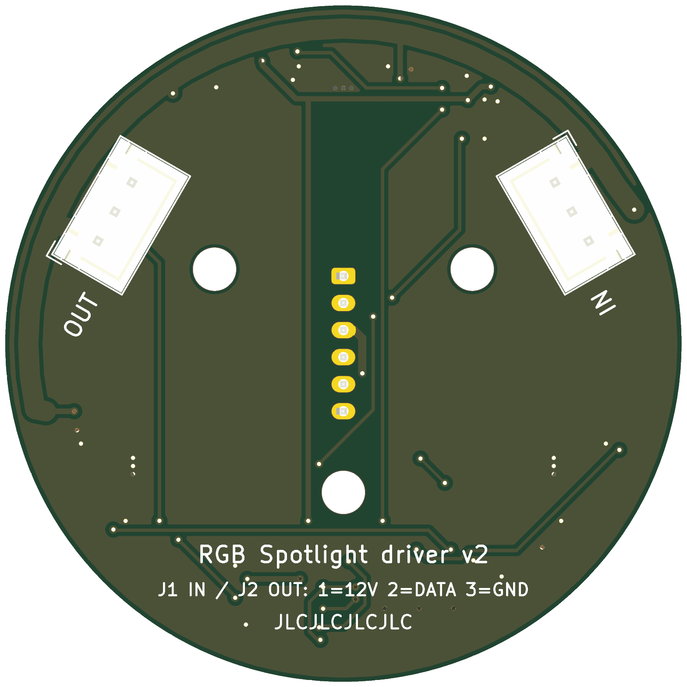
docs/previews/driver/render-bottom.png
