somebox/rgb-spotlight/docs/previews/driver/render-top.png

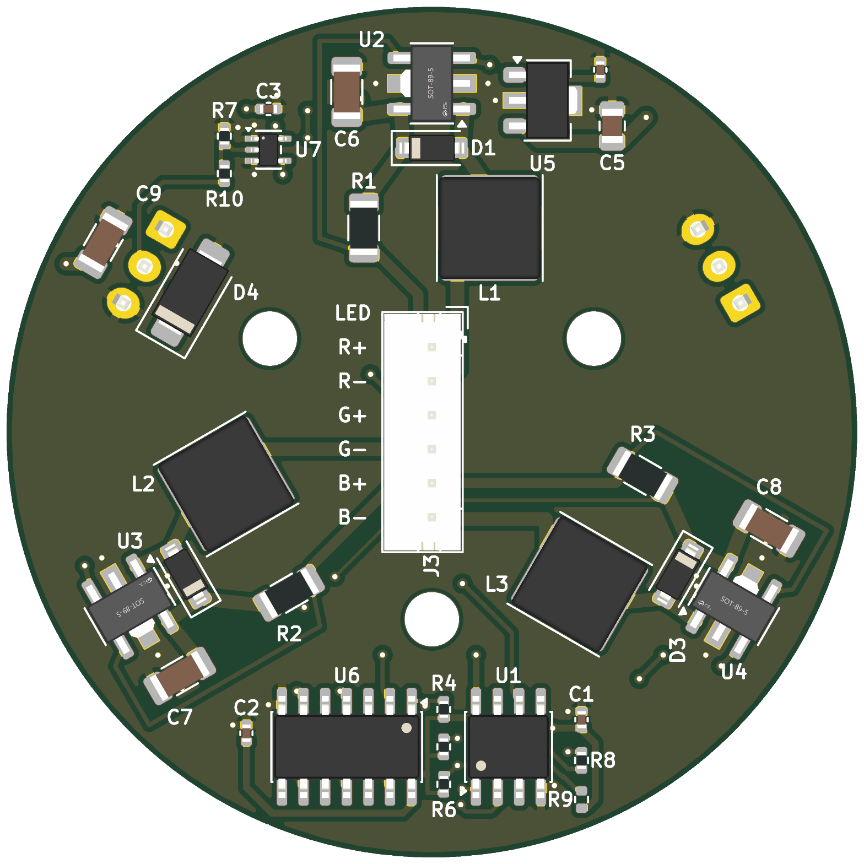
docs/previews/driver/render-top.png
