somebox/rgb-spotlight/docs/previews/led/pcb-front.png

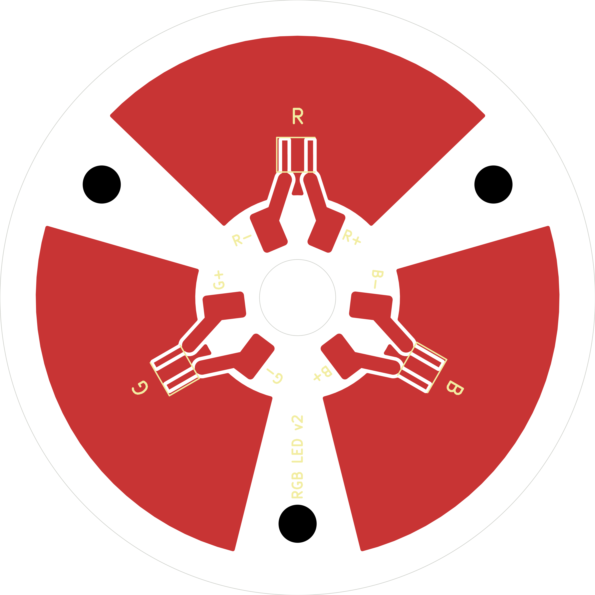
docs/previews/led/pcb-front.png
