somebox/rgb-spotlight/docs/previews/led/render-bottom.png

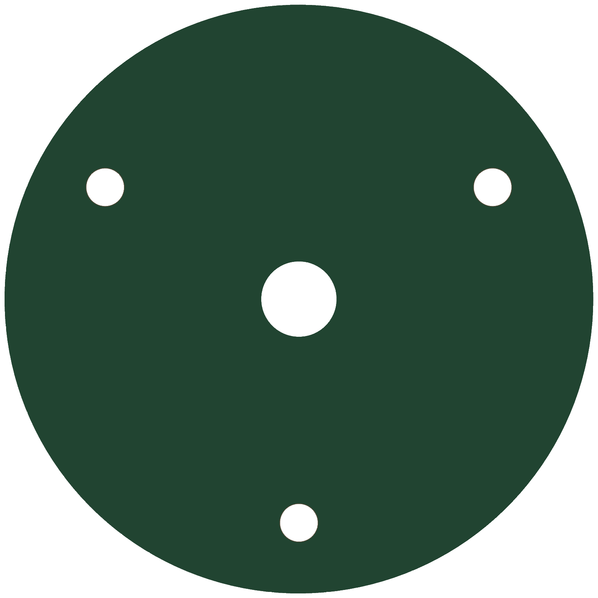
docs/previews/led/render-bottom.png
