somebox/rgb-spotlight/docs/previews/led/render-top.png

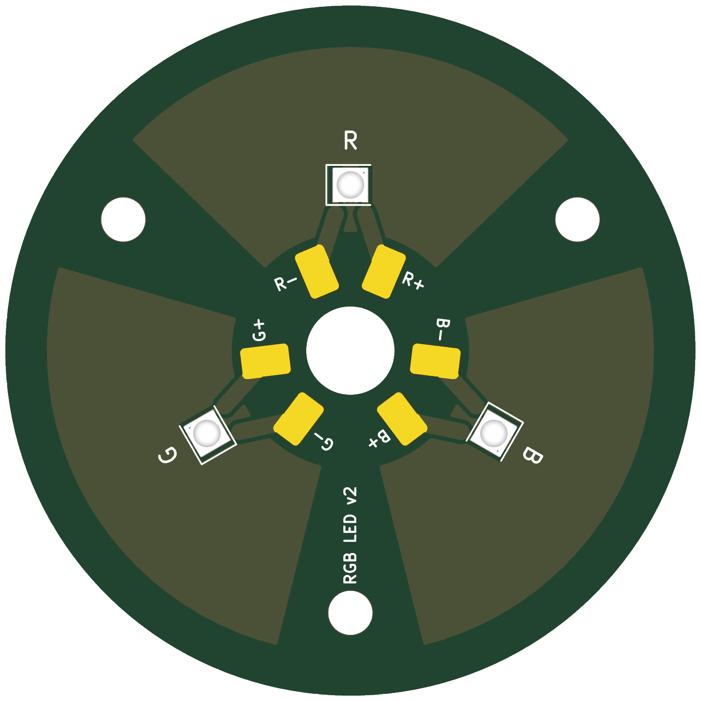
docs/previews/led/render-top.png
