somebox/rgb-spotlight/docs/previews/outline-presets.png

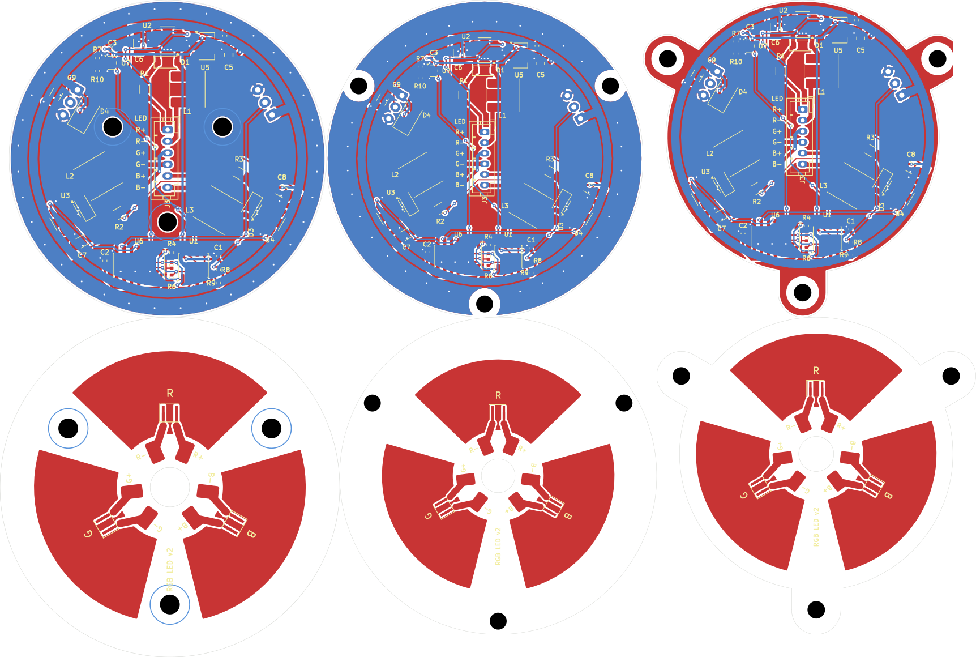
docs/previews/outline-presets.png
