somebox/rgb-spotlight/docs/v1-schematic.png

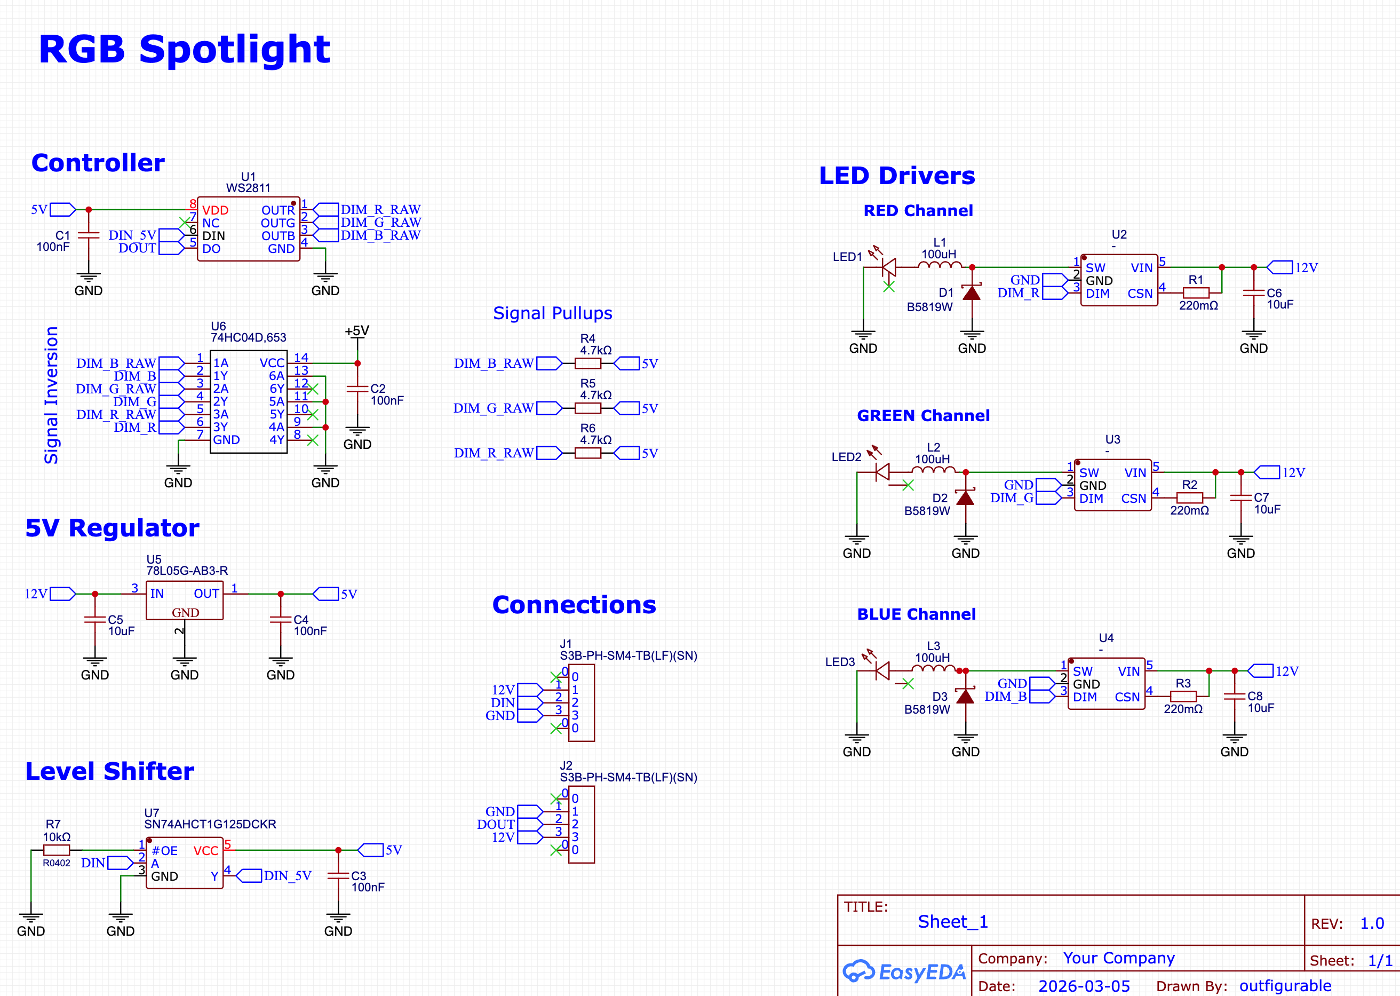
docs/v1-schematic.png
