somebox/rgb-spotlight/media/v1-pcb.png

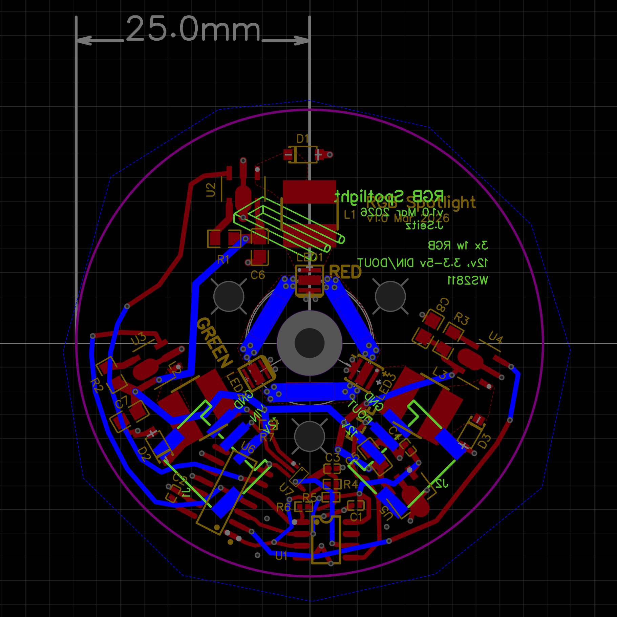
media/v1-pcb.png
