somebox/rgb-spotlight/docs/BOM_led.md

# rgb-spotlight-led

RGB Spotlight v2 LED board (aluminium, 1 layer): 3x XINGLIGHT HD2525

**3 line items (3 unique parts), ~$0.77 estimated (qty 1)**

## BOM

| Ref | Qty | LCSC | Package | Note | Stock | Price |
| --- | --- | --- | --- | --- | --- | --- |
| [LED1](#c49237857) | 1 | C49237857 | SMD | HD2525 red 620nm | 2,625 | $0.2728 |
| [LED2](#c49237859) | 1 | C49237859 | SMD | HD2525 green 525nm | 325 | $0.2925 |
| [LED3](#c49237860) | 1 | C49237860 | SMD | HD2525 blue 455nm | 1,331 | $0.2080 |

## Details

### C49237857

| | |
|---|---|
| **Designator** | LED1 |
| **Part** | XL-HD2525SURC-A4 |
| **LCSC** | C49237857 |
| **Manufacturer** | XINGLIGHT |
| **Package** | SMD |
| **Type** | Extended |
| **Quantity** | 1 |
| **Description** | -40℃~+135℃ 120° 2.4V 2.5mm x 2.5mm square LED 3W 620nm 625nm 700mA Discrete Diode Red Water Clear SMD LED Indication - Discrete ROHS |
| **Notes** | HD2525 red 620nm |
| **Stock** | 2,625 |
| **Pricing** | $0.2728 (≥1), $0.2141 (≥50), $0.1891 (≥150), $0.1577 (≥500), $0.1439 (≥2500), $0.1355 (≥5000) |
| **Color Temperature** | - |
| **Diode Configuration** | Discrete Diode |
| **Illumination Color** | Red |
| **Lamp Holder Type** | 2.5mm x 2.5mm square LED |
| **Lens Color** | Water Clear |
| **Luminous Intensity** | - |
| **Mounting Style** | - |
| **Operating Temperature** | -40℃~+135℃ |
| **Peak Wavelength** | 625nm |
| **Power(Watts)** | 3W |
| **Test Current** | 700mA |
| **Viewing Angle** | 120° |
| **Voltage - Forward(Vf)** | 2.4V |
| **Wavelength - Dominant** | 620nm |
| **JLCPCB** | https://jlcpcb.com/partdetail/XINGLIGHT-XL_HD2525SURCA4/C49237857 |

### C49237859

| | |
|---|---|
| **Designator** | LED2 |
| **Part** | XL-HD2525UGC-A4 |
| **LCSC** | C49237859 |
| **Manufacturer** | XINGLIGHT |
| **Package** | SMD |
| **Type** | Extended |
| **Quantity** | 1 |
| **Description** | -40℃~+135℃ 120° 2.5mm x 2.5mm square LED 3.4V 3W 525nm 525nm 700mA Discrete Diode Green Water Clear SMD LED Indication - Discrete ROHS |
| **Notes** | HD2525 green 525nm |
| **Stock** | 325 |
| **Pricing** | $0.2925 (≥1), $0.2293 (≥50), $0.2021 (≥150), $0.1681 (≥500), $0.1556 (≥2500), $0.1465 (≥5000) |
| **Color Temperature** | - |
| **Diode Configuration** | Discrete Diode |
| **Illumination Color** | Green |
| **Lamp Holder Type** | 2.5mm x 2.5mm square LED |
| **Lens Color** | Water Clear |
| **Luminous Intensity** | - |
| **Mounting Style** | - |
| **Operating Temperature** | -40℃~+135℃ |
| **Peak Wavelength** | 525nm |
| **Power(Watts)** | 3W |
| **Test Current** | 700mA |
| **Viewing Angle** | 120° |
| **Voltage - Forward(Vf)** | 3.4V |
| **Wavelength - Dominant** | 525nm |
| **JLCPCB** | https://jlcpcb.com/partdetail/XINGLIGHT-XL_HD2525UGCA4/C49237859 |

### C49237860

| | |
|---|---|
| **Designator** | LED3 |
| **Part** | XL-HD2525UBC-A4 |
| **LCSC** | C49237860 |
| **Manufacturer** | XINGLIGHT |
| **Package** | SMD |
| **Type** | Extended |
| **Quantity** | 1 |
| **Description** | -40℃~+135℃ 120° 2.5mm x 2.5mm square LED 27lm~45lm 3.4V 3000V 3W 455nm 455nm 700mA Blue Discrete Diode Water Clear SMD LED Indication - Discrete ROHS |
| **Notes** | HD2525 blue 455nm |
| **Stock** | 1,331 |
| **Pricing** | $0.2080 (≥1), $0.1628 (≥50), $0.1436 (≥150), $0.1194 (≥500), $0.1086 (≥2000), $0.1023 (≥4000) |
| **Color Temperature** | - |
| **Diode Configuration** | Discrete Diode |
| **ESD Withstand Voltage** | 3000V |
| **Illumination Color** | Blue |
| **Lamp Holder Type** | 2.5mm x 2.5mm square LED |
| **Lens Color** | Water Clear |
| **Lumens** | 27lm~45lm |
| **Luminous Intensity** | - |
| **Mounting Style** | - |
| **Operating Temperature** | -40℃~+135℃ |
| **Peak Wavelength** | 455nm |
| **Power(Watts)** | 3W |
| **Test Current** | 700mA |
| **Viewing Angle** | 120° |
| **Voltage - Forward(Vf)** | 3.4V |
| **Wavelength - Dominant** | 455nm |
| **JLCPCB** | https://jlcpcb.com/partdetail/XINGLIGHT-XL_HD2525UBCA4/C49237860 |
