somebox/rgb-spotlight/docs/BOM_driver.csv

Ref | LCSC | Qty | Part | Manufacturer | Package | Description | Price | Stock | Type | Notes | Datasheet | JLCPCB URL
C1-C4 | C1525 | 4 | CL05B104KO5NNNC | Samsung Electro-Mechanics | 0402 | 100nF 16V X7R ±10% 0402 Multilayer Ceramic Capacitors MLCC - SMD/SMT ROHS | 0.0045 | 22162126 | base | 100nF X7R bypass: C1 WS2811, C2 74HC04, C3 74AHCT1G125, C4 78L05 out | https://www.lcsc.com/datasheet/lcsc_datasheet_2304140030_Samsung-Electro-Mechanics-CL05B104KO5NNNC_C1525.pdf | https://jlcpcb.com/partdetail/1877-CL05B104KO5NNNC/C1525
C5 | C15850 | 1 | CL21A106KAYNNNE | Samsung Electro-Mechanics | 0805 | 10uF 25V X5R ±10% 0805 Multilayer Ceramic Capacitors MLCC - SMD/SMT ROHS | 0.0651 | 4918817 | base | 10uF 25V 0805, 78L05 input | https://www.lcsc.com/datasheet/lcsc_datasheet_2304140030_Samsung-Electro-Mechanics-CL21A106KAYNNNE_C15850.pdf | https://jlcpcb.com/partdetail/16532-CL21A106KAYNNNE/C15850
C6-C8 | C13585 | 3 | CL31A106KBHNNNE | Samsung Electro-Mechanics | 1206 | 10uF 50V X5R ±10% 1206 Multilayer Ceramic Capacitors MLCC - SMD/SMT ROHS | 0.2655 | 2382882 | base | 10uF 50V X5R 1206, PT4115 VIN bypass (>=4.7uF after DC bias at 12V) | https://www.lcsc.com/datasheet/lcsc_datasheet_2304140030_Samsung-Electro-Mechanics-CL31A106KBHNNNE_C13585.pdf | https://jlcpcb.com/partdetail/14236-CL31A106KBHNNNE/C13585
C9 | C12891 | 1 | CL31A226KAHNNNE | Samsung Electro-Mechanics | 1206 | 22uF 25V X5R ±10% 1206 Multilayer Ceramic Capacitors MLCC - SMD/SMT ROHS | 0.0494 | 1082676 | base | 22uF 25V X5R 1206, 12V input bulk | https://www.lcsc.com/datasheet/lcsc_datasheet_2304140030_Samsung-Electro-Mechanics-CL31A226KAHNNNE_C12891.pdf | https://jlcpcb.com/partdetail/13537-CL31A226KAHNNNE/C12891
D1-D3 | C64885 | 3 | B5819W | MDD(Microdiode Semiconductor) | SOD-123 | -55℃~+125℃ 1.5A 1mA@40V 25A 40V 600mV@1A Standalone SOD-123 Schottky Diodes ROHS | 0.0194 | 933876 | expand | B5819W 40V/1A Schottky freewheeling diode | https://www.lcsc.com/datasheet/lcsc_datasheet_2407291648_MDD-Microdiode-Semiconductor-B5819W_C64885.pdf | https://jlcpcb.com/partdetail/MDD_Microdiode_Semiconductor-B5819W/C64885
D4 | C19077535 | 1 | SMAJ15A | hongjiacheng | DO-214AC(SMA) | -55℃~+150℃ 1 15V 16.4A@10/1000us 18.5V 1uA 24.4V 400W@10/1000us IEC 61000-4-2 TVS Unidirectional DO-214AC(SMA) ESD and Surge Protection (TVS/ESD) ROHS | 0.0371 | 109695 | expand | SMAJ15A TVS on +12V (hot-plugged chain cables) | https://www.lcsc.com/datasheet/lcsc_datasheet_2411041728_hongjiacheng-SMAJ15A_C19077535.pdf | https://jlcpcb.com/partdetail/hongjiacheng-SMAJ15A/C19077535
J1-J2 | C144394 | 2 | B3B-XH-A(LF)(SN) | JST | Plugin,P=2.5mm | -25℃~+85℃ 1 1x3P 2.5mm 250V 3 3A 3P 5.75mm 7mm 9.9mm Brass K Pin PA66 Through Hole Tin UL94V-0 White XH 插件,P=2.5mm Wire To Board Connector ROHS | 0.0542 | 175004 | expand | JST XH 3P vertical THT (3 A), IN/OUT on the back: 1=12V 2=DATA 3=GND | https://www.lcsc.com/datasheet/lcsc_datasheet_2304140030_JST-B3B-XH-A-LF-SN_C144394.pdf | https://jlcpcb.com/partdetail/JST-B3B_XH_A_LF_SN/C144394
J3 | C131342 | 1 | B6B-PH-K-S(LF)(SN) | JST | Plugin,P=2mm | -25℃~+85℃ 1 100V 13.9mm 1x6P 2A 2mm 4.5mm 6 6P 6mm Brass K Pin PA66 PH Through Hole Tin UL94V-0 White 插件,P=2mm Wire To Board Connector ROHS | 0.0722 | 74983 | expand | JST PH 6P vertical THT, LED harness: R+ R- G+ G- B+ B- | https://www.lcsc.com/datasheet/lcsc_datasheet_1811151524_JST-B6B-PH-K-S-LF-SN_C131342.pdf | https://jlcpcb.com/partdetail/JST-B6B_PH_K_S_LF_SN/C131342
L1-L3 | C168091 | 3 | FNR6045S680MT | cjiang (Changjiang Microelectronics Tech) | SMD,6x6mm | 1.1A 1.3A 376mΩ 68uH Magnetic Shielded Inductor ±20% SMD,6x6mm Power Inductors ROHS | 0.0695 | 34298 | expand | 68uH FNR6045S680MT, Isat 1.1A; PT4115 table 47-68uH for 0.4-0.8A | https://www.lcsc.com/datasheet/lcsc_datasheet_2304140030_cjiang--Changjiang-Microelectronics-Tech-FNR6045S680MT_C168091.pdf | https://jlcpcb.com/partdetail/179474-FNR6045S680MT/C168091
R1-R3 | C2907349 | 3 | FRL1206FR220TS | FOJAN | 1206 | -55℃~+155℃ 220mΩ 250mW 500V Thick Film Resistor ±1% ±300ppm/℃ 1206 Chip Resistor - Surface Mount ROHS | 0.0071 | 43689 | expand | 0.22R 1% 1206 300ppm, current sense: 0.1V/0.22R = 455mA | https://wmsc.lcsc.com/wmsc/upload/file/pdf/v2/lcsc/2308241947_FOJAN-FRL1206FR220TS_C2907349.pdf | https://jlcpcb.com/partdetail/FOJAN-FRL1206FR220TS/C2907349
R4-R6 | C25900 | 3 | 0402WGF4701TCE | UNI-ROYAL(Uniroyal Elec) | 0402 | -55℃~+155℃ 4.7kΩ 50V 62.5mW Thick Film Resistor ±1% ±100ppm/℃ 0402 Chip Resistor - Surface Mount ROHS | 0.0027 | 15438980 | base | 4.7k pull-up for WS2811 open-drain outputs | https://www.lcsc.com/datasheet/lcsc_datasheet_2206010045_UNI-ROYAL-Uniroyal-Elec-0402WGF4701TCE_C25900.pdf | https://jlcpcb.com/partdetail/26643-0402WGF4701TCE/C25900
R7 | C25744 | 1 | 0402WGF1002TCE | UNI-ROYAL(Uniroyal Elec) | 0402 | -55℃~+155℃ 10kΩ 50V 62.5mW Thick Film Resistor ±1% ±100ppm/℃ 0402 Chip Resistor - Surface Mount ROHS | 0.0034 | 21677422 | base | 10k DIN pull-down (defined low when unplugged) | https://www.lcsc.com/datasheet/lcsc_datasheet_2411221126_UNI-ROYAL-Uniroyal-Elec-0402WGF1002TCE_C25744.pdf | https://jlcpcb.com/partdetail/26487-0402WGF1002TCE/C25744
R8 | C25105 | 1 | 0402WGF330JTCE | UNI-ROYAL(Uniroyal Elec) | 0402 | -55℃~+155℃ 33Ω 50V 62.5mW Thick Film Resistor ±1% ±100ppm/℃ 0402 Chip Resistor - Surface Mount ROHS | 0.0012 | 1815221 | base | 33R series on DOUT (cable source termination) | https://www.lcsc.com/datasheet/lcsc_datasheet_2205311900_UNI-ROYAL-Uniroyal-Elec-0402WGF330JTCE_C25105.pdf | https://jlcpcb.com/partdetail/25848-0402WGF330JTCE/C25105
R10 | C25076 | 1 | 0402WGF1000TCE | UNI-ROYAL(Uniroyal Elec) | 0402 | -55℃~+155℃ 100Ω 50V 62.5mW Thick Film Resistor ±1% ±100ppm/℃ 0402 Chip Resistor - Surface Mount ROHS | 0.0008 | 2868420 | base | 100R series on DIN | https://www.lcsc.com/datasheet/lcsc_datasheet_2205311900_UNI-ROYAL-Uniroyal-Elec-0402WGF1000TCE_C25076.pdf | https://jlcpcb.com/partdetail/25819-0402WGF1000TCE/C25076
U1 | C114581 | 1 | WS2811 | Worldsemi | SOP-8 | -25℃~+85℃ 16.5mA 20V 3 5V~24V 800kHz Over Voltage Protection、Short-Circuit Protection PWM SOP-8 LED Drivers ROHS | 0.0413 | 111712 | expand | WS2811 pixel controller, SET pin floated for 800kHz | https://www.lcsc.com/datasheet/lcsc_datasheet_1810081420_Worldsemi-WS2811_C114581.pdf | https://jlcpcb.com/partdetail/Worldsemi-WS2811/C114581
U2-U4 | C347356 | 3 | PT4115 | UMW(Youtai Semiconductor Co., Ltd.) | SOT-89-5 | -25℃~+85℃ 1.2A 1MHz 5% 6V~30V Analog、PWM Buck Built-in DC-DC Over-Temperature Protection (OTP) SOT-89-5 LED Drivers ROHS | 0.1104 | 100444 | expand | PT4115 buck LED driver, one per RGB channel | https://www.lcsc.com/datasheet/lcsc_datasheet_1912111437_UMW-Youtai-Semiconductor-Co---Ltd--PT4115_C347356.pdf | https://jlcpcb.com/partdetail/324016-PT4115/C347356
U5 | C71136 | 1 | 78L05G-AB3-R | UTC(Unisonic Tech) | SOT-89-3 | -40℃~+85℃ 1 1.7V@(40mA) 100mA 2mA 30V 40uV 5V 80dB@(120Hz) Fixed Over Current Protection、Short Circuit Protection、Thermal Shutdown Positive SOT-89-3 Voltage Regulators - Linear, Low Drop Out (LDO) Regulators ROHS | 0.0893 | 226961 | base | 78L05 5V regulator, basic part | https://www.lcsc.com/datasheet/lcsc_datasheet_2304140030_UTC-Unisonic-Tech-78L05G-AB3-R_C71136.pdf | https://jlcpcb.com/partdetail/UTC_Unisonic_Tech-78L05G_AB3R/C71136
U6 | C5590 | 1 | 74HC04D,653 | Nexperia | SOIC-14 | -40℃~+125℃ 1 1.5V~4.2V 1.9V、3.7V、5.2V 100mV、400mV、400mV 14ns@6V,50pF 2V~6V 2uA 5.2mA 5.2mA 500mV~1.8V 6 74HC SOIC-14 Inverters ROHS | 0.1290 | 39344 | expand | 74HC04 hex inverter, WS2811 open-drain inversion | https://www.lcsc.com/datasheet/lcsc_datasheet_2407241044_Nexperia-74HC04D-653_C5590.pdf | https://jlcpcb.com/partdetail/Nexperia-74HC04D653/C5590
U7 | C350557 | 1 | SN74AHCT1G125DCKR | Texas Instruments | SC-70-5 | -40℃~+125℃ 1 1 10uA 4.5V~5.5V 5.5ns@5V,15pF 74AHCT 8mA 8mA Tri-State Unidirectional SC-70-5 Buffers, Drivers, Receivers, Transceivers ROHS | 0.1418 | 17039 | expand | SN74AHCT1G125 3.3V-to-5V level shifter on DIN | https://www.lcsc.com/datasheet/lcsc_datasheet_1912111437_Texas-Instruments-SN74AHCT1G125DCKR_C350557.pdf | https://jlcpcb.com/partdetail/TexasInstruments-SN74AHCT1G125DCKR/C350557
