somebox/rgb-spotlight/docs/jlcpcb-tool-guide.md

# jlcpcb-tool Guide (Moved)

This project now uses `bomi` instead of the legacy `jlcpcb` command.

See `docs/bomi-tool-guide.md` for the current command reference and workflow.
