somebox/rgb-spotlight/docs/previews/driver/assembly-back.png

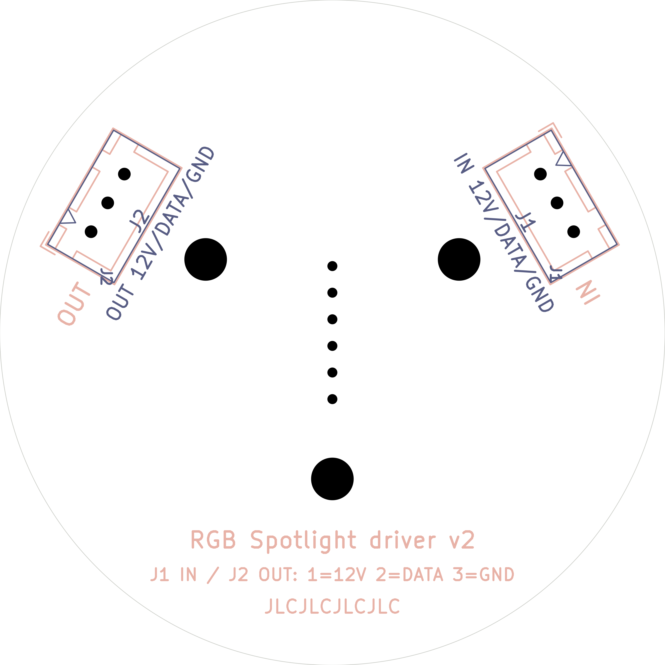
docs/previews/driver/assembly-back.png
