somebox/rgb-spotlight/docs/previews/led/assembly-back.png

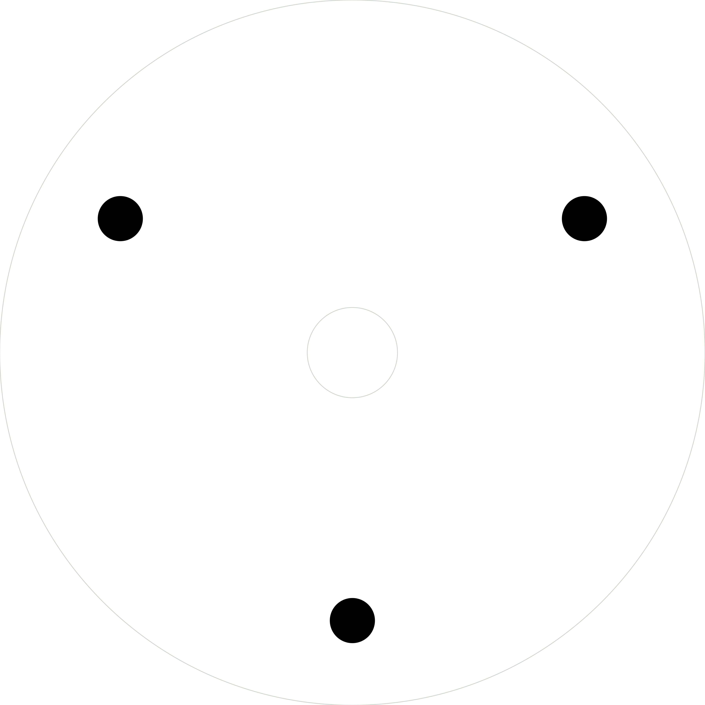
docs/previews/led/assembly-back.png
