somebox/rgb-spotlight/sim/results/channel_full.png

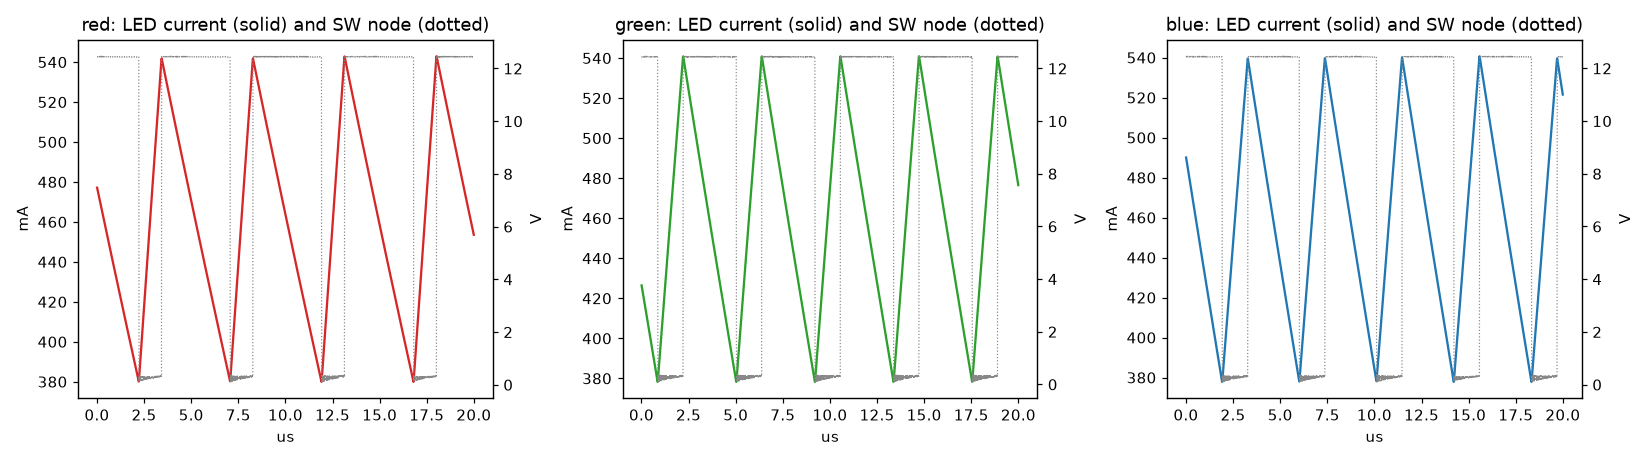
sim/results/channel_full.png
