somebox/rgb-spotlight/sim/results/channel_pwm.png

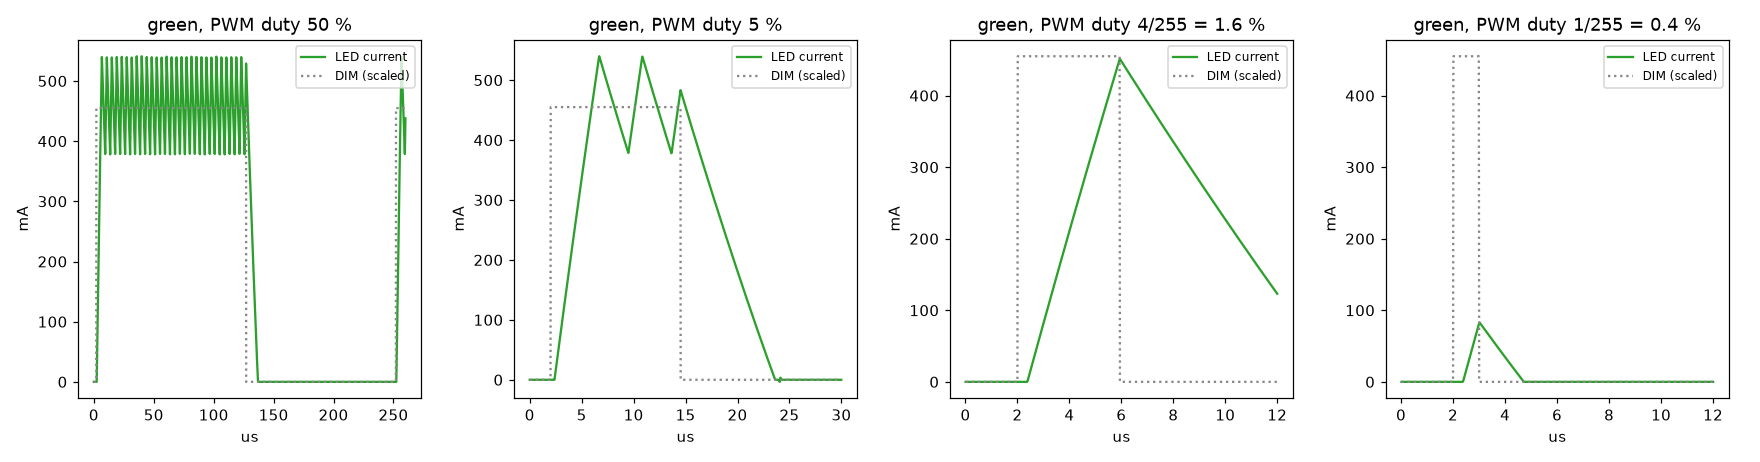
sim/results/channel_pwm.png
