somebox/rgb-spotlight/docs/previews/driver/schematic.pdf

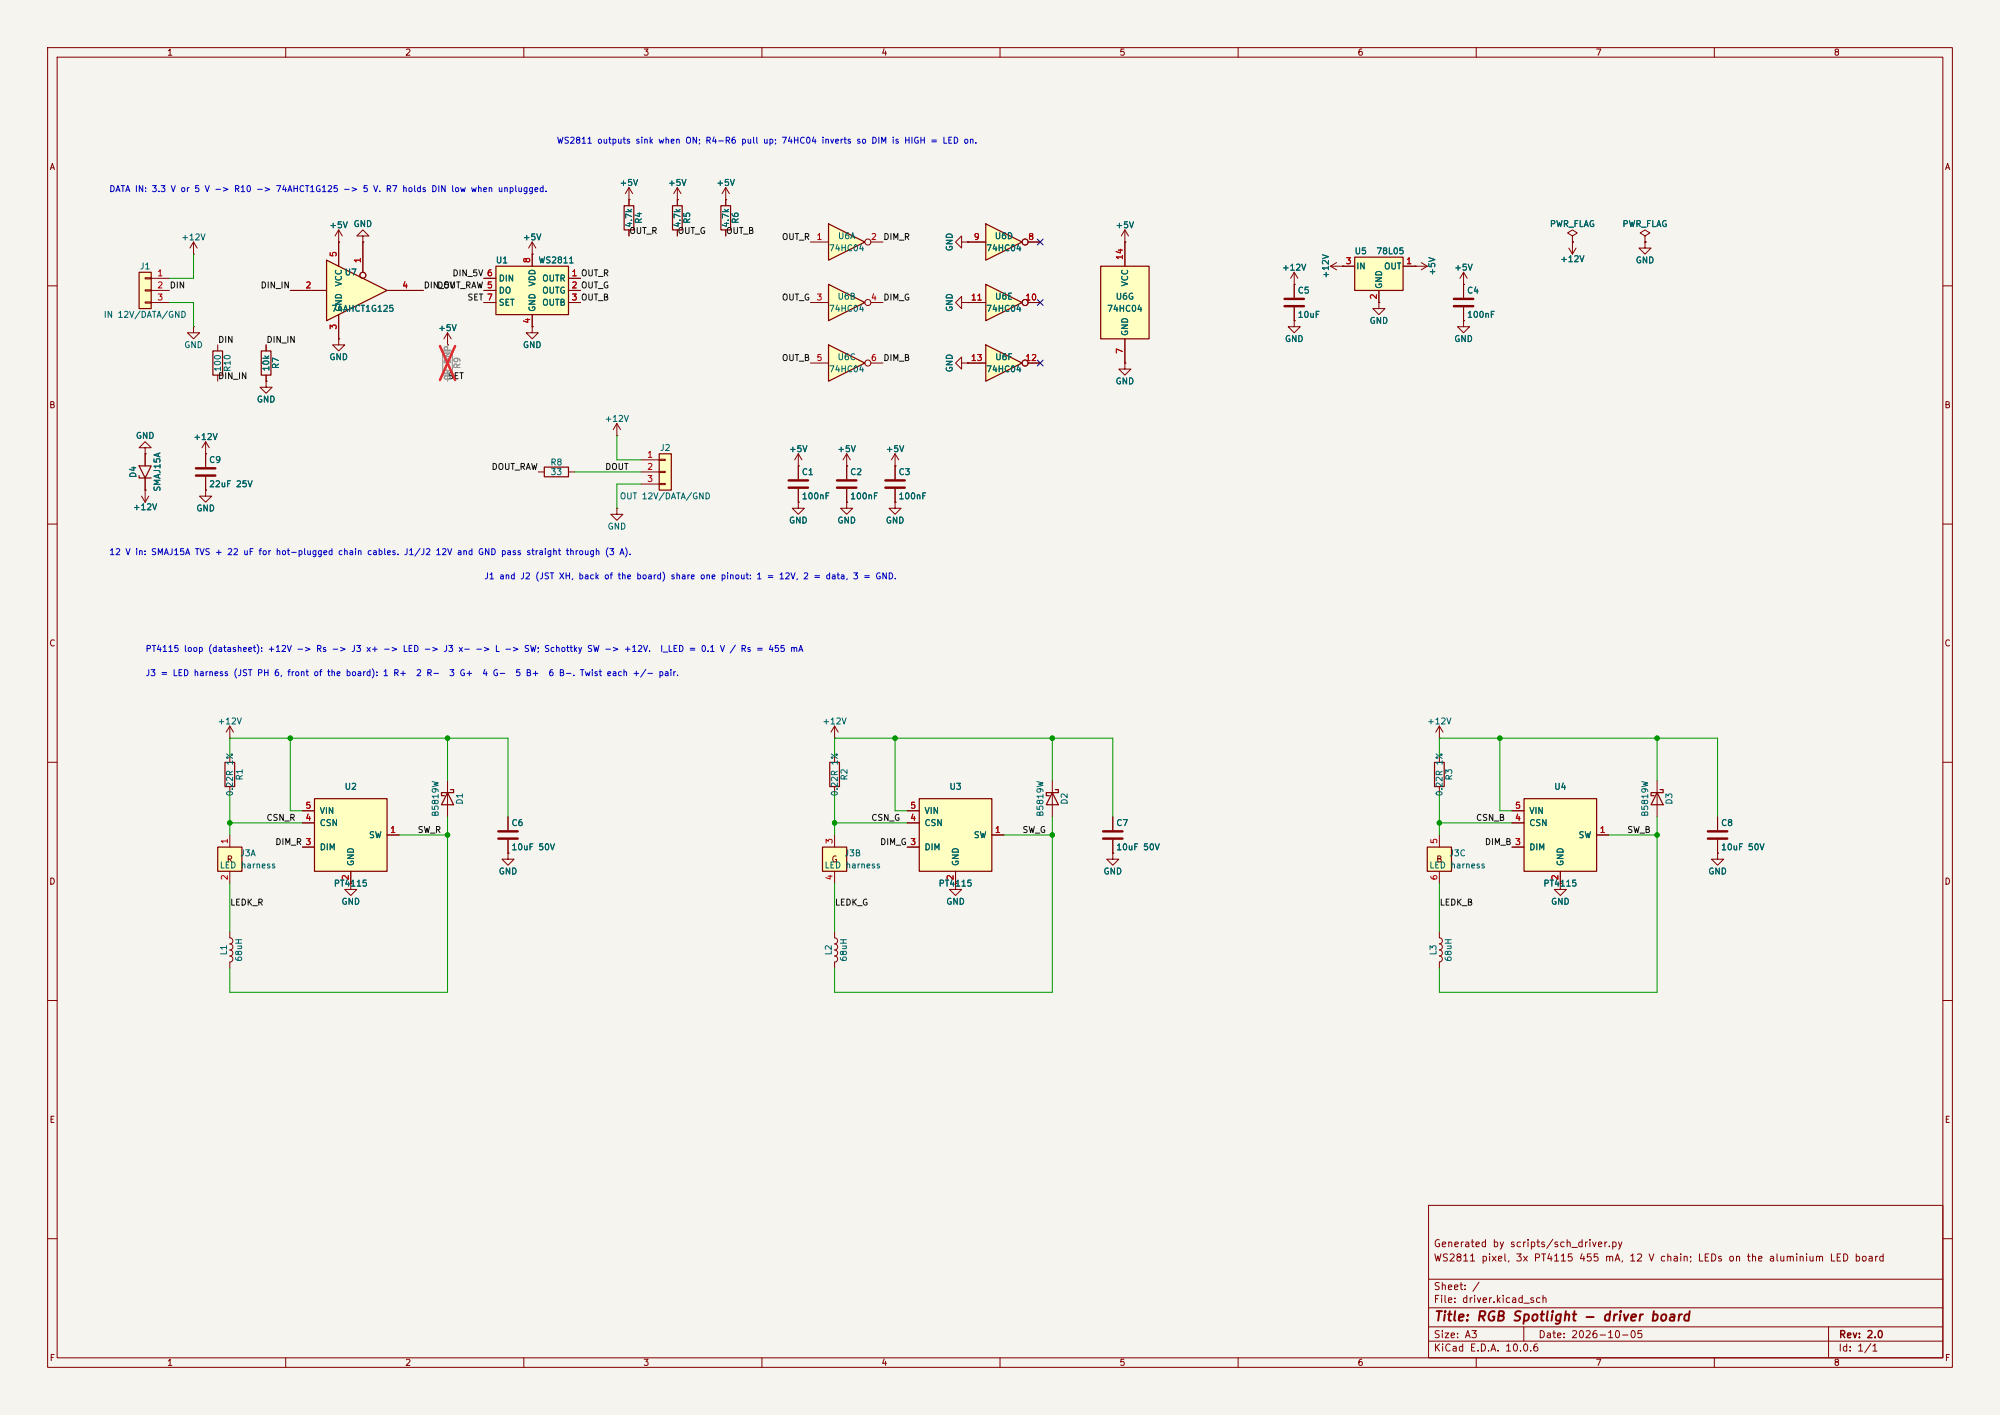
[picture p18: page 1]

DATA IN: 3.3 V or 5 V -> R10 -> 74AHCT1G125 -> 5 V. R7 holds DIN low when unplugged. WS2811 outputs sink when ON; R4-R6 pull up; 74HC04 inverts so DIM is HIGH = LED on.

Generated by scripts/sch_driver.py R4 4.7k
OUT_R

5 +5V GND U1 WS2811 OUTR 1 OUTG 2 OUTB 3 GND

WS2811 pixel, 3x PT4115 455 mA, 12 V chain; LEDs on the aluminium LED board

Sheet: /
File: driver.kicad_sch
Title: RGB Spotlight - driver board

Size: A3 | Rev: 2.0 | F Date: 2026-10-05
KiCad E.D.A. 10.0.6 | Id: 1/1
