somebox/rgb-spotlight/docs/previews/led/schematic.pdf

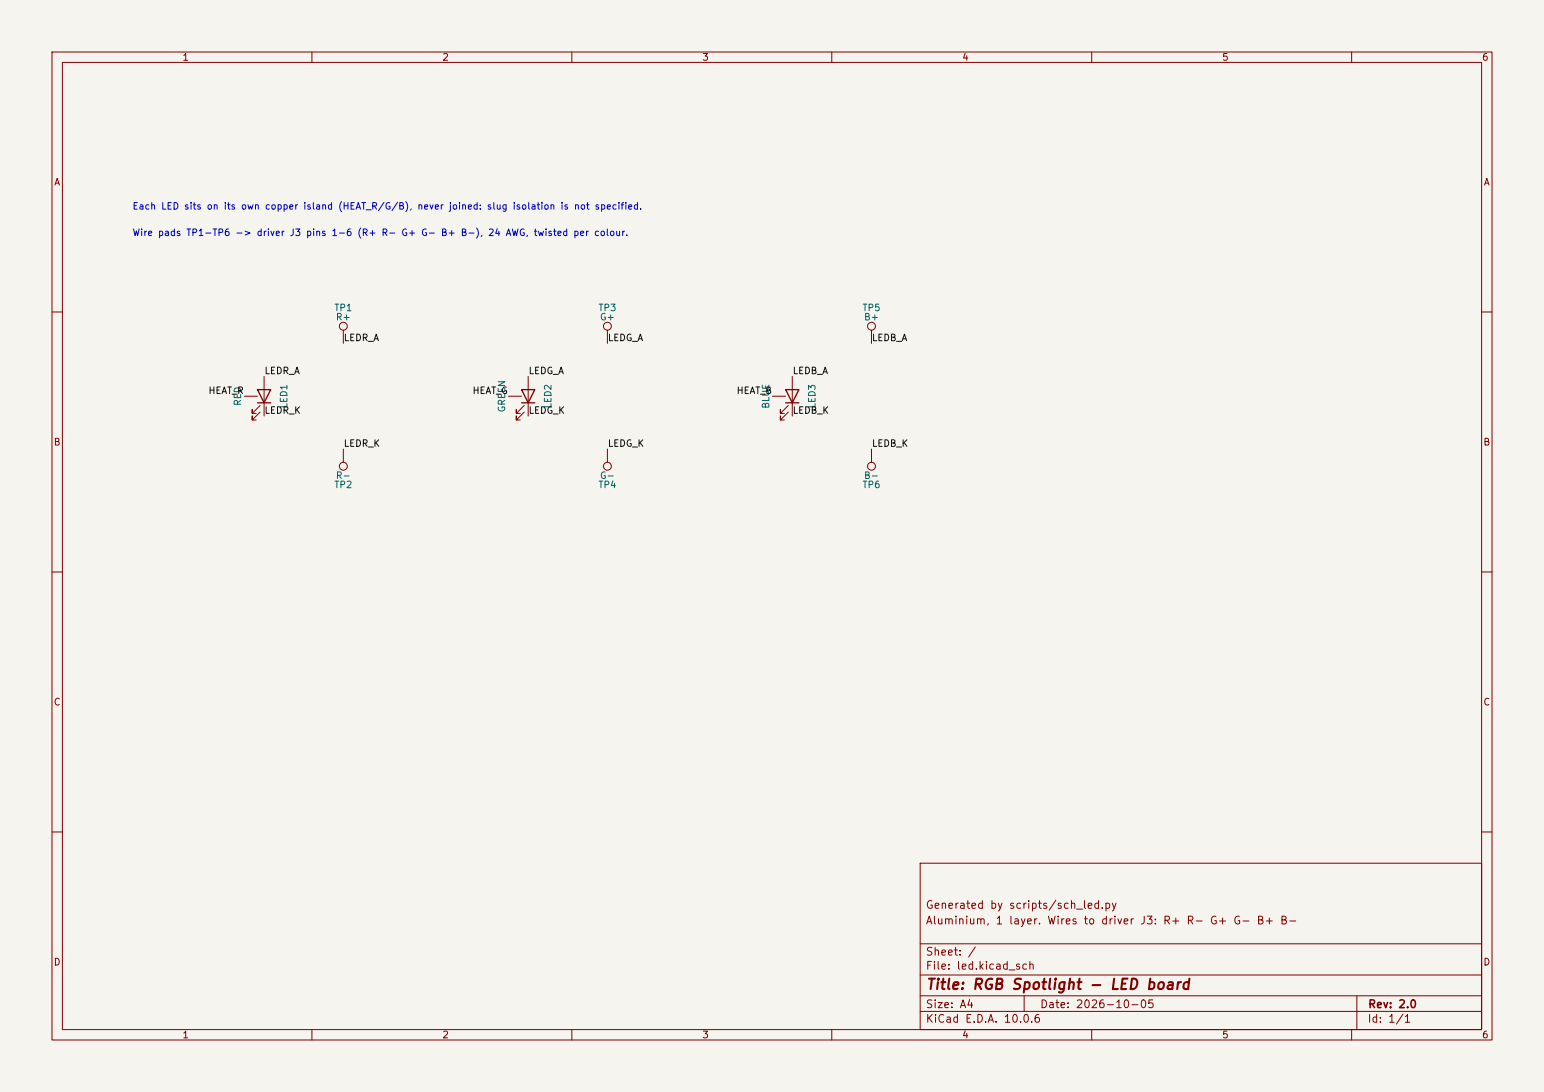
[picture p19: page 1]

LEDR_A Each LED sits on its own copper island (HEAT_R/G/B), never joined: slug isolation is not specified. Wire pads TP1-TP6 -> driver J3 pins 1-6 (R+ R- G+ G- B+ B-), 24 AWG, twisted per colour.

LEDB_A HEAT_G
Generated by scripts/sch_led.py LED2 GREEN

Aluminium, 1 layer. Wires to driver J3: R+ R- G+ G- B+ B-

Sheet: /
File: led.kicad_sch
Title: RGB Spotlight - LED board

Size: A4 | Rev: 2.0
KiCad E.D.A. 10.0.6 | Id: 1/1
