somebox/rgb-spotlight/docs/previews/driver/board.pdf

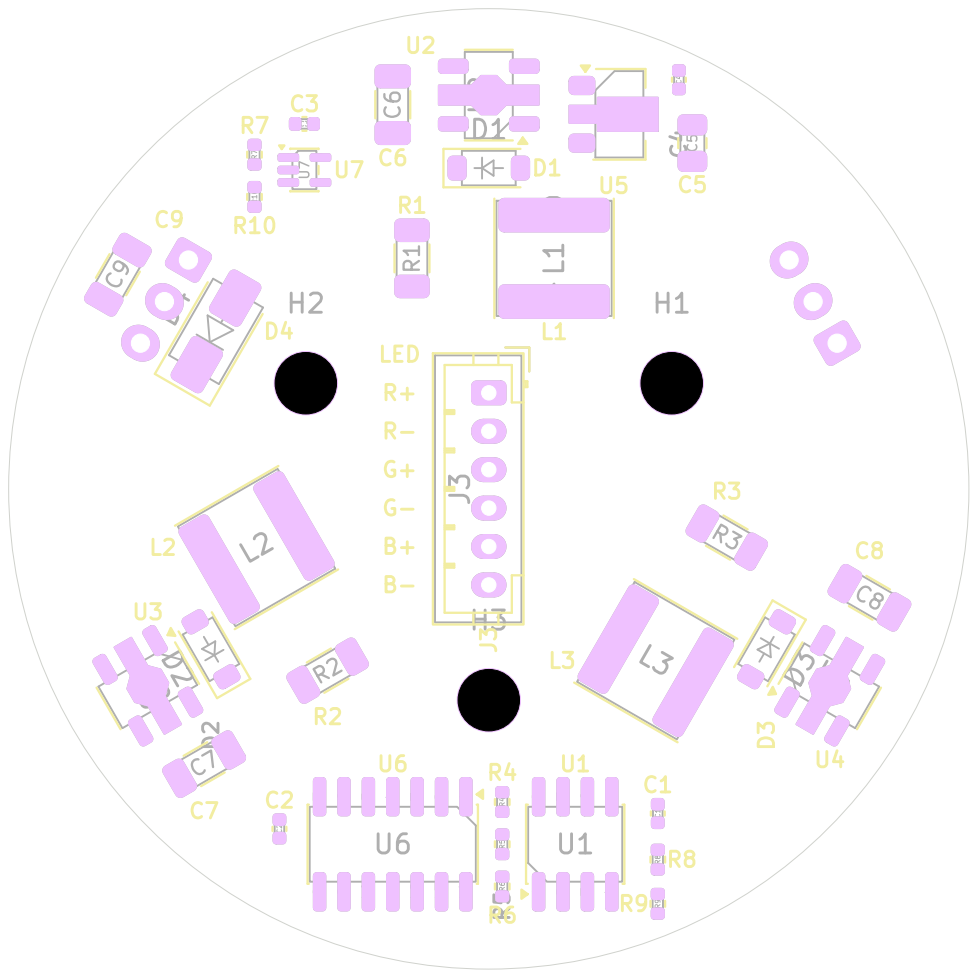
[picture p20: page 1]

FRONT, seen from the front. Scale 1:1
placement by scripts/gen_driver_pcb.py; FR4 2 layers; J1/J2 on the back

Sheet:
File: driver.kicad_pcb
Title: RGB Spotlight - driver board
KiCad E.D.A. 10.0.6

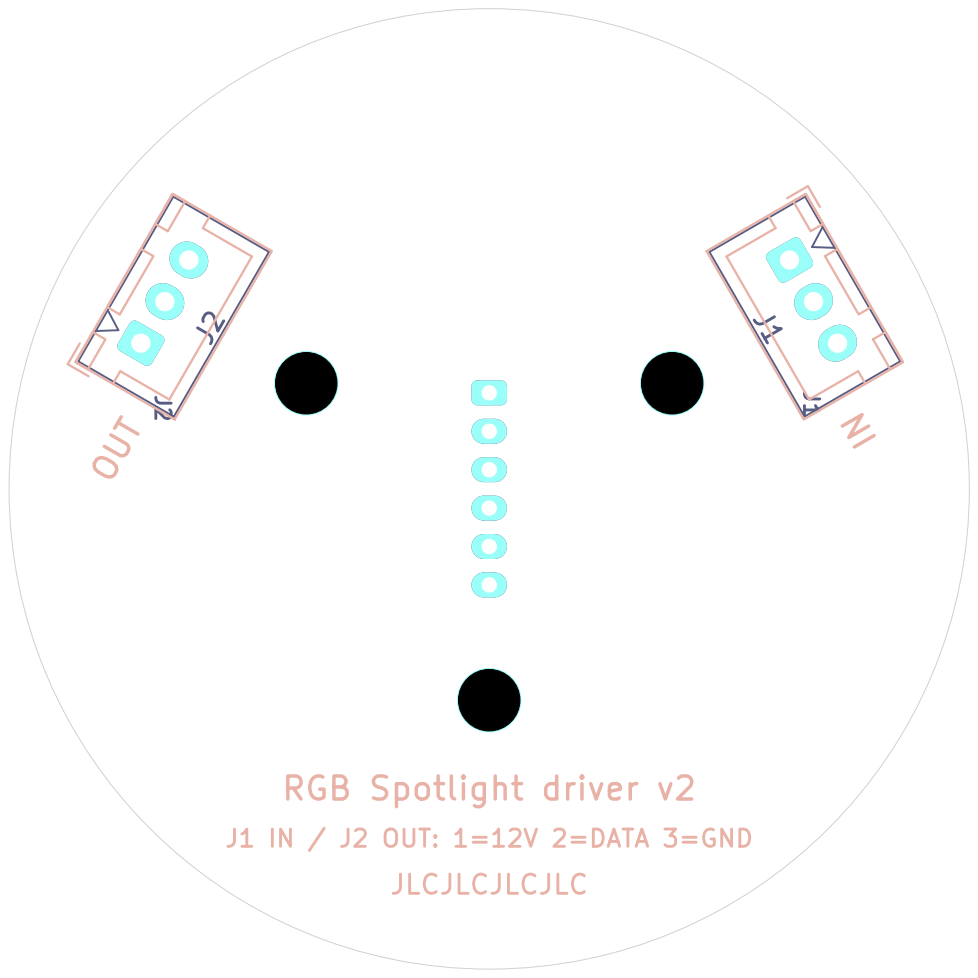
[picture p21: page 2]
D Date: 2026-10-05; Size: A4; Rev: 2.0; BACK, mirrored: seen from the back. Scale 1:1 J2 J2; IN OUT

3 J1 IN / J2 OUT: 1=12V 2=DATA 3=GND

JLCJLCJLCJLC RGB Spotlight driver v2

placement by scripts/gen_driver_pcb.py; FR4 2 layers; J1/J2 on the back

Sheet:
File: driver.kicad_pcb
Title: RGB Spotlight - driver board
KiCad E.D.A. 10.0.6
