somebox/rgb-spotlight/docs/previews/led/board.pdf

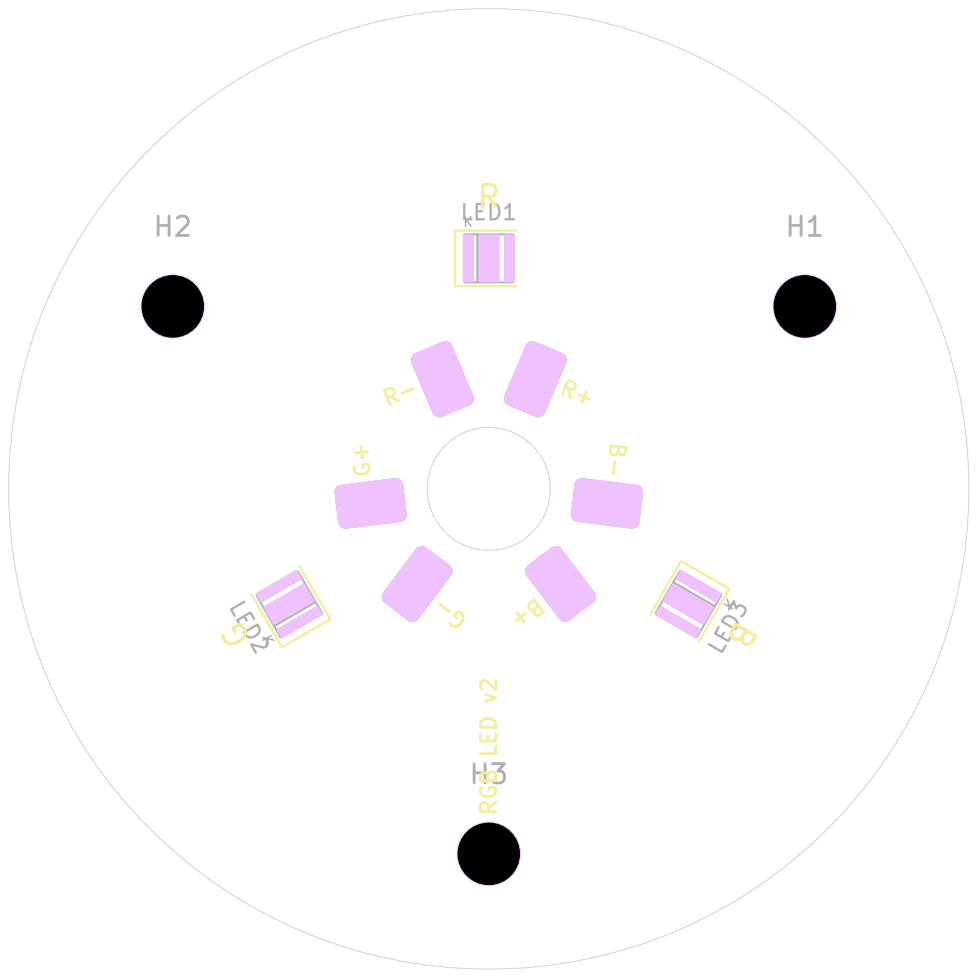
[picture p22: page 1]
D Date: 2026-10-05; Size: A4; Rev: 2.0; LED3K H1H1 H3H3; LED1 K LED2K; RGB LED v2 G+

FRONT, seen from the front. Scale 1:1
ALUMINIUM, 1 layer (F.Cu only). Generated by scripts/gen_led_pcb.py

Sheet:
File: led.kicad_pcb
Title: RGB Spotlight - LED board
KiCad E.D.A. 10.0.6

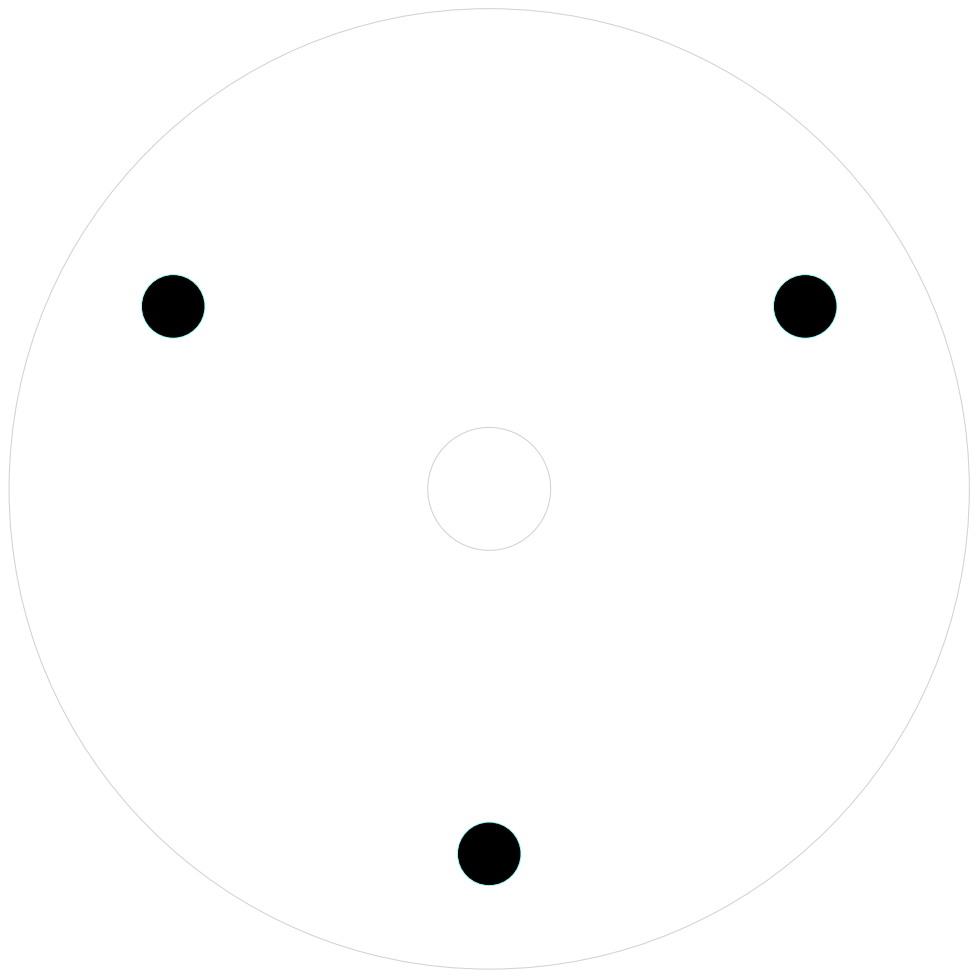
[picture p23: page 2]
D Date: 2026-10-05; Size: A4; Rev: 2.0

BACK, mirrored: seen from the back. Scale 1:1
ALUMINIUM, 1 layer (F.Cu only). Generated by scripts/gen_led_pcb.py

Sheet:
File: led.kicad_pcb
Title: RGB Spotlight - LED board
KiCad E.D.A. 10.0.6
