somebox/rgb-spotlight/(list of files, drawings)

Other design files:
archive/v1-easyeda/PCB_PCB_rgb-discreet-leds_2026-10-05.json
archive/v1-easyeda/SCH_rgb-discreet-leds_2026-10-05.json
