somebox/rgb-spotlight/boards/led/led.kicad_pcb

## KiCad design boards/led/led.kicad_pcb (2026-10-30)

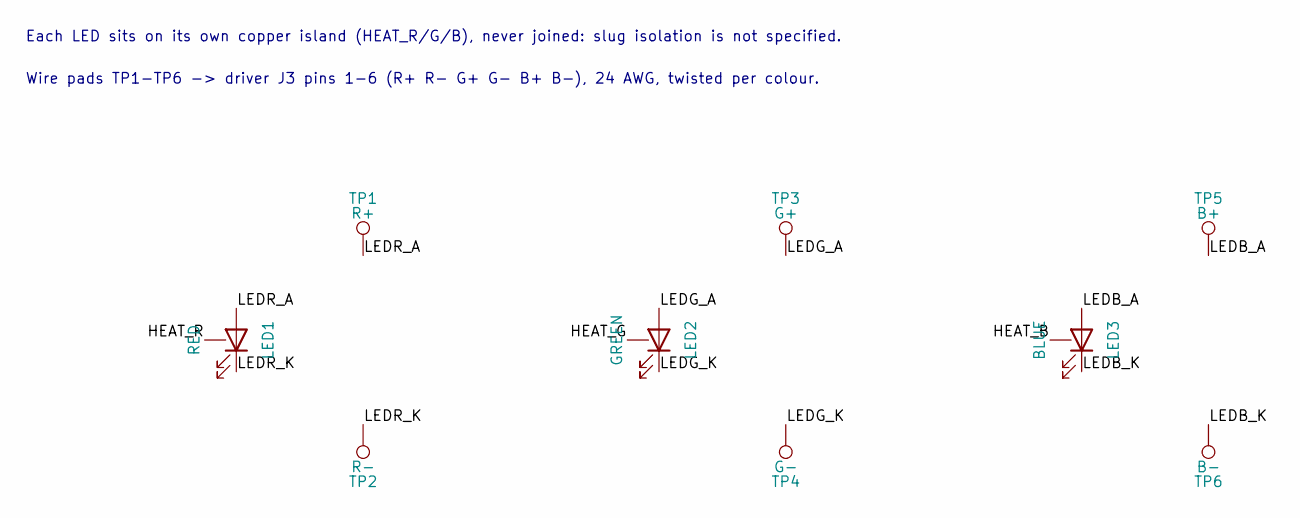
[picture p24: schematic led.kicad_sch, RGB Spotlight - LED board]

Parts:
LED1: RED; LED_XINGLIGHT_HD2525; MPN XL-HD2525SURC-A4; LCSC C49237857
LED2: GREEN; LED_XINGLIGHT_HD2525; MPN XL-HD2525UGC-A4; LCSC C49237859
LED3: BLUE; LED_XINGLIGHT_HD2525; MPN XL-HD2525UBC-A4; LCSC C49237860
TP1: R+; WirePad_2.2x3.5mm
TP2: R-; WirePad_2.2x3.5mm
TP3: G+; WirePad_2.2x3.5mm
TP4: G-; WirePad_2.2x3.5mm
TP5: B+; WirePad_2.2x3.5mm
TP6: B-; WirePad_2.2x3.5mm

Connections:
/HEAT_B: LED3.3 (PAD)
/HEAT_G: LED2.3 (PAD)
/HEAT_R: LED1.3 (PAD)
/LEDB_A: LED3.2 (A), TP5.1
/LEDB_K: LED3.1 (K), TP6.1
/LEDG_A: LED2.2 (A), TP3.1
/LEDG_K: LED2.1 (K), TP4.1
/LEDR_A: LED1.2 (A), TP1.1
/LEDR_K: LED1.1 (K), TP2.1

Notes on the sheet:
Each LED sits on its own copper island (HEAT_R/G/B), never joined: slug isolation is not specified.
Wire pads TP1-TP6 -> driver J3 pins 1-6 (R+ R- G+ G- B+ B-), 24 AWG, twisted per colour.

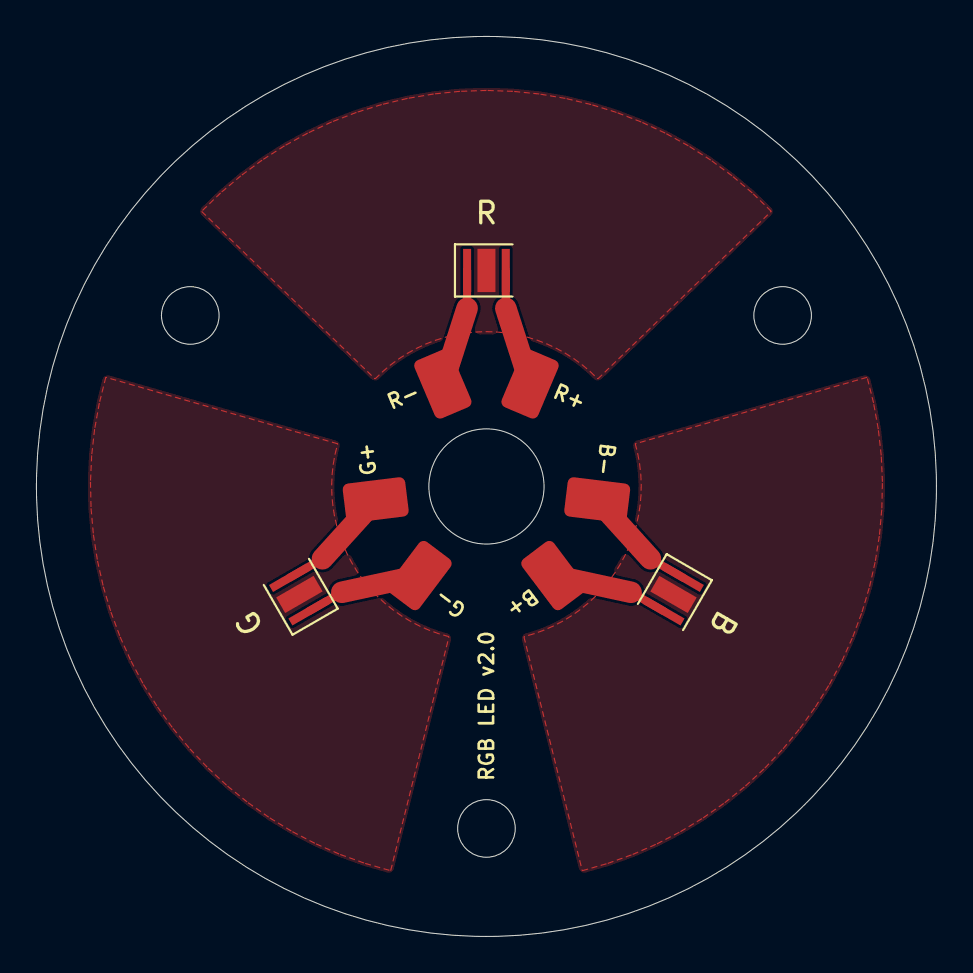
[picture p25: board led.kicad_pcb from above]

Board: 2 copper layers, 50.0 x 50.0 mm, 12 parts (0 on the bottom side), 6 nets.

Other parts of the board:
H1, H2, H3: M3; MountingHole_3.2mm_M3
