somebox/rgb-spotlight/boards/driver/driver.kicad_pcb

## KiCad design boards/driver/driver.kicad_pcb (2026-10-30)

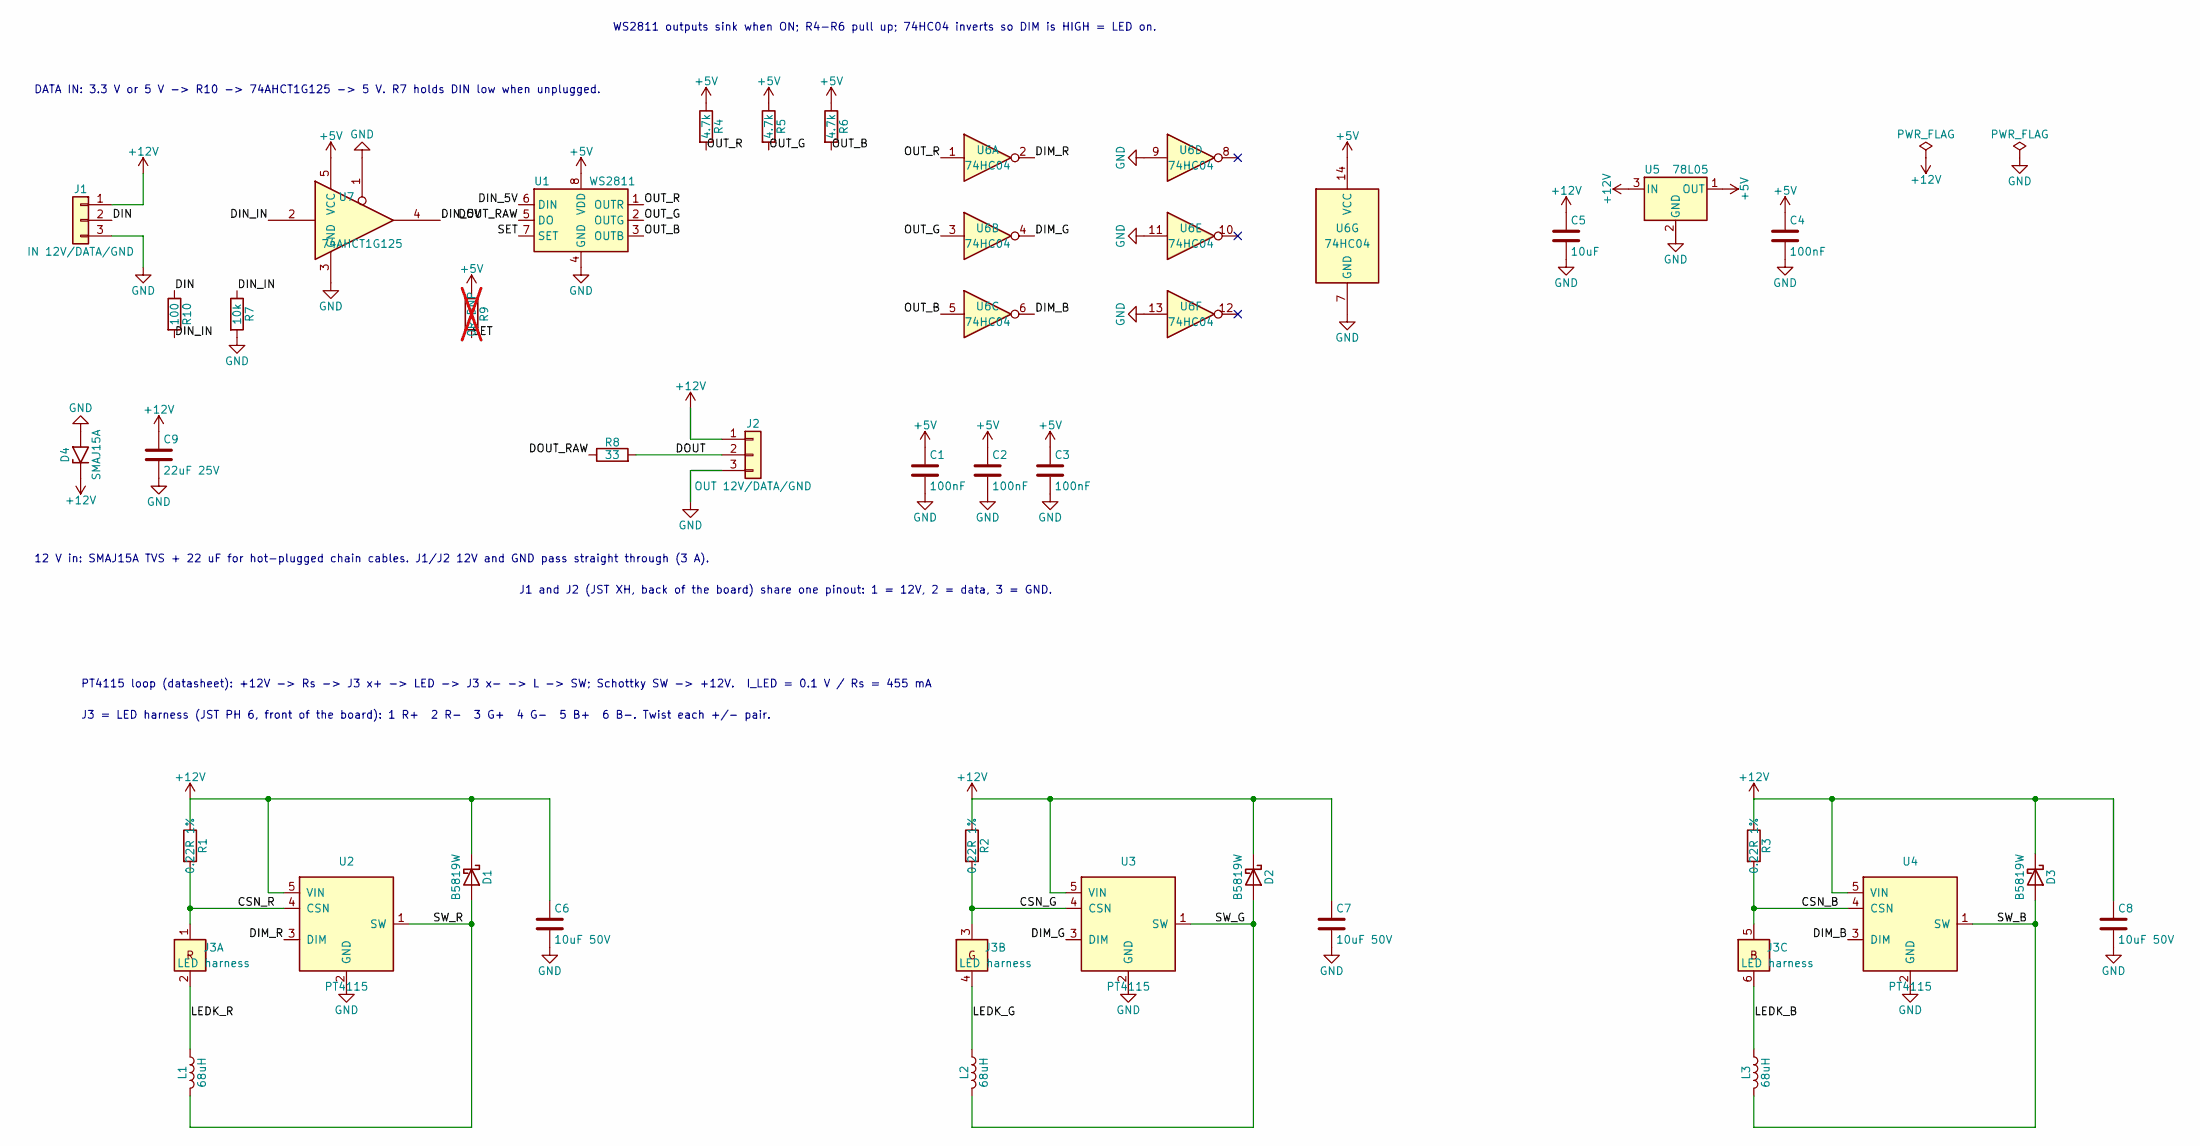
[picture p26: schematic driver.kicad_sch, RGB Spotlight - driver board]

Parts:
C1, C2, C3, C4: 100nF; C_0402_1005Metric; LCSC C1525
C5: 10uF; C_0805_2012Metric; LCSC C15850
C6, C7, C8: 10uF 50V; C_1206_3216Metric; MPN CL31A106KBHNNNE; LCSC C13585
C9: 22uF 25V; C_1206_3216Metric; MPN CL31A226KAHNNNE; LCSC C12891
D1, D2, D3: B5819W; D_SOD-123; LCSC C64885
D4: SMAJ15A; D_SMA; LCSC C19077535
J1: IN 12V/DATA/GND; JST_XH_B3B-XH-A_1x03_P2.50mm_Vertical; MPN B3B-XH-A(LF)(SN); LCSC C144394
J2: OUT 12V/DATA/GND; JST_XH_B3B-XH-A_1x03_P2.50mm_Vertical; MPN B3B-XH-A(LF)(SN); LCSC C144394
J3: LED harness; JST_PH_B6B-PH-K_1x06_P2.00mm_Vertical; MPN B6B-PH-K-S(LF)(SN); LCSC C131342
L1, L2, L3: 68uH; L_Changjiang_FNR6045S; MPN FNR6045S680MT; LCSC C168091
R1, R2, R3: 0.22R 1%; R_1206_3216Metric; MPN FRL1206FR220TS; LCSC C2907349
R4, R5, R6: 4.7k; R_0402_1005Metric; LCSC C25900
R7: 10k; R_0402_1005Metric; LCSC C25744
R8: 33; R_0402_1005Metric; LCSC C25105
R9: 0R DNP; R_0402_1005Metric; not fitted
R10: 100; R_0402_1005Metric; LCSC C25076
U1: WS2811; SOIC-8_3.9x4.9mm_P1.27mm; LCSC C114581
U2, U3, U4: PT4115; SOT-89-5; LCSC C347356
U5: 78L05; SOT-89-3; MPN 78L05G-AB3-R; LCSC C71136
U6: 74HC04; SOIC-14_3.9x8.7mm_P1.27mm; MPN 74HC04D,653; LCSC C5590
U7: 74AHCT1G125; SOT-353_SC-70-5; MPN SN74AHCT1G125DCKR; LCSC C350557

Connections:
+5V: C1.1, C2.1, C3.1, C4.1, R4.1, R5.1, R6.1, R9.1, U1.8 (VDD), U5.1 (OUT), U6.14 (VCC), U7.5 (VCC)
+12V: C5.1, C6.1, C7.1, C8.1, C9.1, D1.1 (K), D2.1 (K), D3.1 (K), D4.1 (A1), J1.1, J2.1, R1.1, R2.1, R3.1, U2.5 (VIN), U3.5 (VIN), U4.5 (VIN), U5.3 (IN)
/CSN_B: J3.5 (B+), R3.2, U4.4 (CSN)
/CSN_G: J3.3 (G+), R2.2, U3.4 (CSN)
/CSN_R: J3.1 (R+), R1.2, U2.4 (CSN)
/DIM_B: U4.3 (DIM), U6.6
/DIM_G: U3.3 (DIM), U6.4
/DIM_R: U2.3 (DIM), U6.2
/DIN: J1.2, R10.1
/DIN_5V: U1.6 (DIN), U7.4
/DIN_IN: R7.1, R10.2, U7.2
/DOUT: J2.2, R8.2
/DOUT_RAW: R8.1, U1.5 (DO)
/LEDK_B: J3.6 (B-), L3.1
/LEDK_G: J3.4 (G-), L2.1
/LEDK_R: J3.2 (R-), L1.1
/OUT_B: R6.2, U1.3 (OUTB), U6.5
/OUT_G: R5.2, U1.2 (OUTG), U6.3
/OUT_R: R4.2, U1.1 (OUTR), U6.1
/SET: R9.2, U1.7 (SET)
/SW_B: D3.2 (A), L3.2, U4.1 (SW)
/SW_G: D2.2 (A), L2.2, U3.1 (SW)
/SW_R: D1.2 (A), L1.2, U2.1 (SW)
GND: C1.2, C2.2, C3.2, C4.2, C5.2, C6.2, C7.2, C8.2, C9.2, D4.2 (A2), J1.3, J2.3, R7.2, U1.4 (GND), U2.2 (GND), U3.2 (GND), U4.2 (GND), U5.2 (GND), U6.7 (GND), U6.9, U6.11, U6.13, U7.1, U7.3 (GND)

Notes on the sheet:
DATA IN: 3.3 V or 5 V -> R10 -> 74AHCT1G125 -> 5 V. R7 holds DIN low when unplugged.
12 V in: SMAJ15A TVS + 22 uF for hot-plugged chain cables. J1/J2 12V and GND pass straight through (3 A).
WS2811 outputs sink when ON; R4-R6 pull up; 74HC04 inverts so DIM is HIGH = LED on.
J1 and J2 (JST XH, back of the board) share one pinout: 1 = 12V, 2 = data, 3 = GND.
PT4115 loop (datasheet): +12V -> Rs -> J3 x+ -> LED -> J3 x- -> L -> SW; Schottky SW -> +12V. I_LED = 0.1 V / Rs = 455 mA
J3 = LED harness (JST PH 6, front of the board): 1 R+ 2 R- 3 G+ 4 G- 5 B+ 6 B-. Twist each +/- pair.

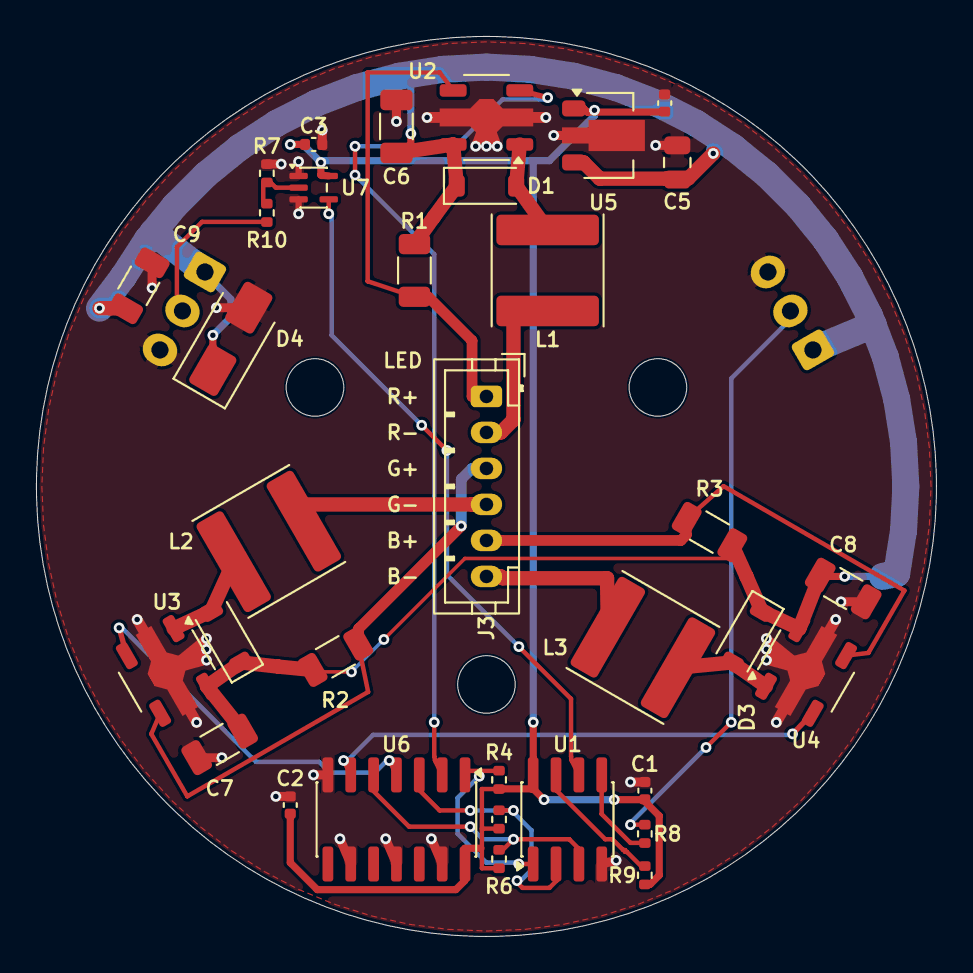
[picture p27: board driver.kicad_pcb from above]

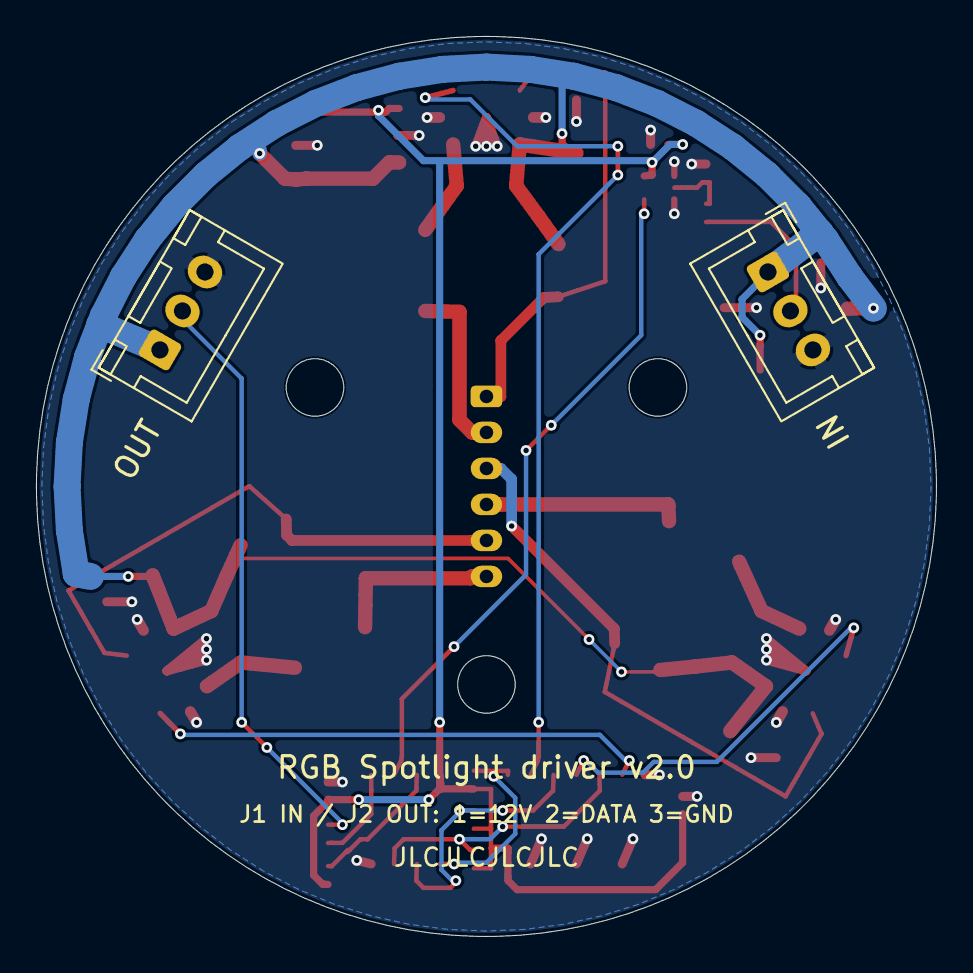
[picture p28: board driver.kicad_pcb from below]

Board: 2 copper layers, 50.0 x 50.0 mm, 39 parts (2 on the bottom side), 24 nets.

Other parts of the board:
H1, H2, H3: M3; MountingHole_3.2mm_M3
