somebox/rgb-spotlight/(commit log)

2026-03-28 update bom to use https://github.com/somebox/bomi for part tracking
    [BOM_rgb-spotlight.csv]
2026-10-10 v2: two-board KiCad design, generated by script, with pcb-kit for the shared tooling
    The v2 restart after the v1 post-mortem (DESIGN.md): an aluminium LED board
    and an FR4 driver board, both generated from scripts/ (schematics through
    konnect, boards with KiCad's Python, scripted routing), with the project
    library in lib/, previews in docs/previews/ and the per-board bomi BOMs.
    The shared parts (schematic builder, silkscreen placer, blank board, DRC/ERC
    summaries, previews, JLC fab files) come from pcb-kit
    (github.com/somebox/pcb-kit; `uv tool install -e ~/src/pcb-kit && pcbkit
    link`). scripts/builder.py is the project glue; netcheck.py keeps the
    driver-board assertions on the kit's netlist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
2026-10-11 v2: LED channel simulation, pcb-kit checks and docs, open 12 V trunk
    sim/channel.py simulates one PT4115 channel in ngspice through pcbkit.spice:
    a behavioural PT4115 (hysteretic switch from the datasheet) with the board's
    real L, Rs, Schottky, caps and supply cable. Full white is 5.0 W, 0.42 A per
    light, 78-83 % efficient, with the Schottky the hottest part. Brightness
    tracks the WS2811 PWM within 5 % above 20 % duty and runs bright below that;
    the lowest levels fall short. Results in DESIGN.md 2.7 and sim/results/.
    pcbkit check on the driver: the 12 V back-layer ring was a closed loop, so
    it is now an arc from J1 over the top to the blue cell's tap, and its dead
    ends are trimmed. The PWR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
2026-10-30 production: adopt pcb-kit's release flow (pcbkit.toml), v2.0 silkscreen labels
    - pcbkit.toml: boards/*, JLC files only; pcbkit release --dry-run passes both boards (would release v2.0)
    - silkscreen "v2" -> "v2.0" so pcbkit release re-stamps it; LED label moved to r = 12.2 mm to clear H3
    - PRODUCTION.md: release/order steps, never-checked SOT-89/SOT-353 rotations, J1/J2 back BOM, overview
    - LAYOUT/README/DESIGN: cleanup --dry-run result, release commands
2026-11-03 review: v2 failure review, power per feed, planned changes, handover
    - docs/reviews/2026-10-30-v2.md: pre-order failure review of both boards
    (findings R1-R14, power and data, bench list, firmware duties, owner's answers)
    - sim/worst_case.py: tolerance corners, Schottky temperature, power per feed,
    5 V feed; sim/data_cable.py: data link over chain cables (R10 100 vs 1k)
    - DESIGN.md: D14-D20 (5 lights per 12 V feed, 3 A fuse, no extra repeater,
    planned 74HC14 / C1 1 uF / R10 1k / LED "+" silk, nylon hardware); power
    table in 2.4; F3 stays open; planned-changes list in 6
    - README, PRODUCTION, LAYOUT: chain limits and status updated
    - HANDOVER.md: how we got here, decisions and the work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
